alexnodeland/lynx/web/README.md

# lynx site






The landing page at https://alexnodeland.github.io/lynx/: a scroll-driven three.js scene (GSAP for the scroll timeline, n8ao for ambient occlusion) built with Vite.

Site hero

## Run locally

```sh
npm ci
npm run dev       # dev server
npm run build     # production build into dist/
npm run preview   # serve dist/
```

## Layout

| Path | Contents |
|---|---|
| `index.html` | the landing page |
| `build.html` | the 3D build guide |
| `flash.html` | the web flasher (ESP Web Tools; CI builds `public/flash/lynx.bin` in) |
| `src/stage.js` | the shared scene: renderer, light, set, product rig, cables, post-processing |
| `src/guide.js` | the build guide's steps (what arrives, from where, what you need) |
| `src/build.js` | the build guide: ghosts, fly-ins, framing, orbit, step rail, `#step` links |
| `src/main.js` | the landing page: scroll timeline, shots, chrome |
| `src/materials.js` | materials |
| `src/style.css` | styles |
| `public/assets/` | `lynx.glb` (the model), `set.glb` (the desk set), `rig.json`, `studio_1k.hdr` |
| `public/draco/` | Draco decoder for the compressed glTF |

## Deploy

[`.github/workflows/pages.yml`](../.github/workflows/pages.yml) runs `npm ci && npm run build` and publishes `dist/` to GitHub Pages on every push to `main` that touches `web/`.

## Screens

| | |
|---|---|
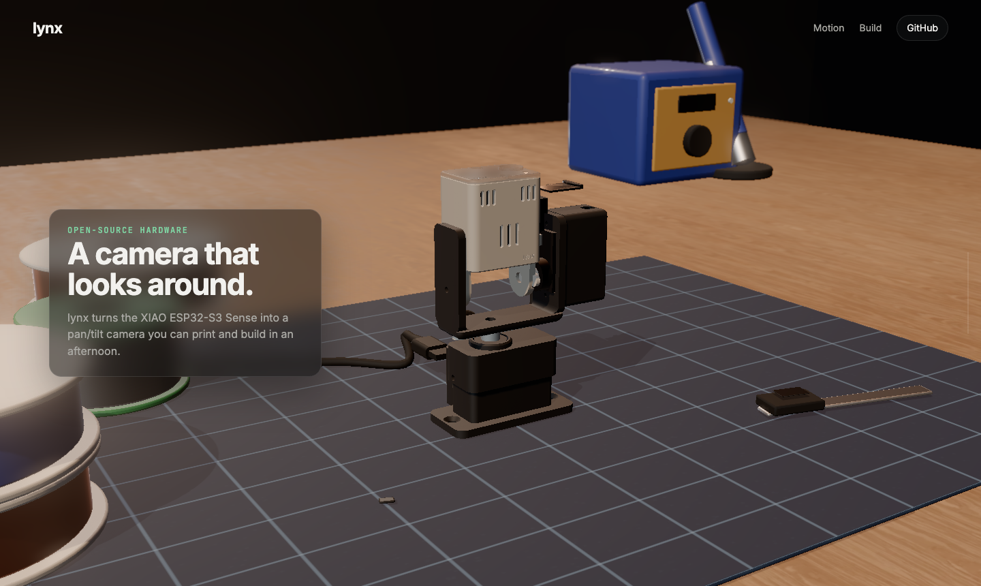
[picture p8: media/web/01-hero.png]
Hero
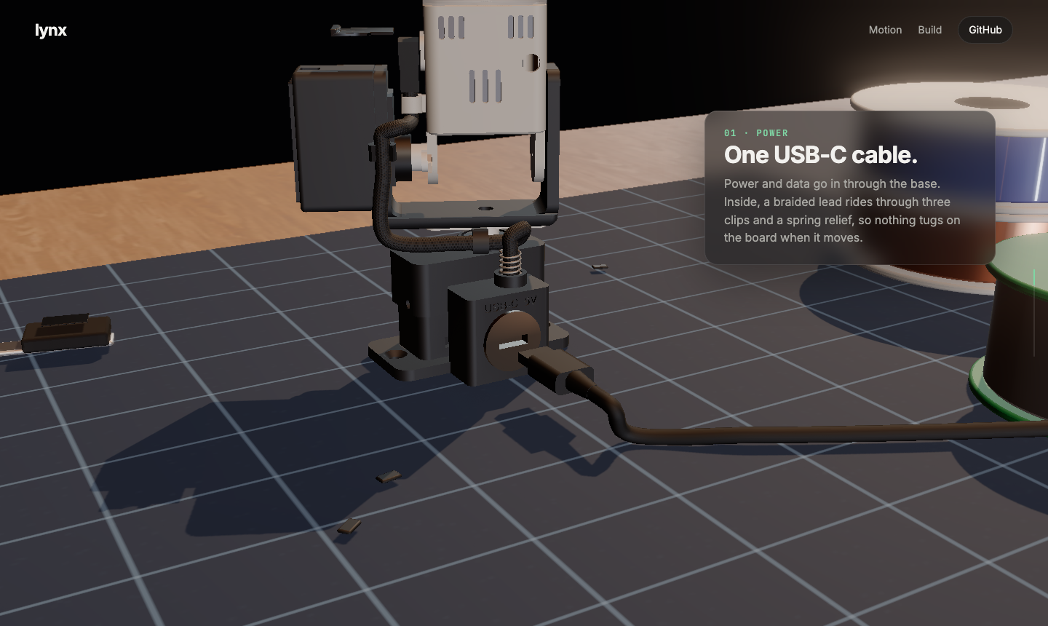
[picture p9: media/web/02-usb.png]
USB-C
|  |  |
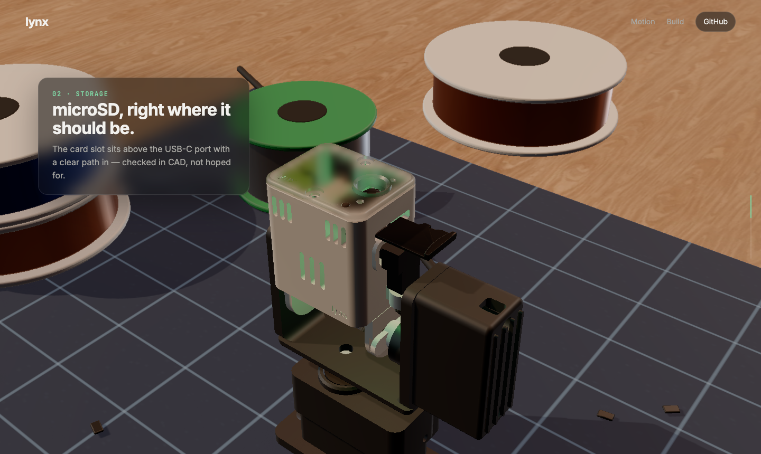
[picture p10: media/web/03-sd.png]
microSD
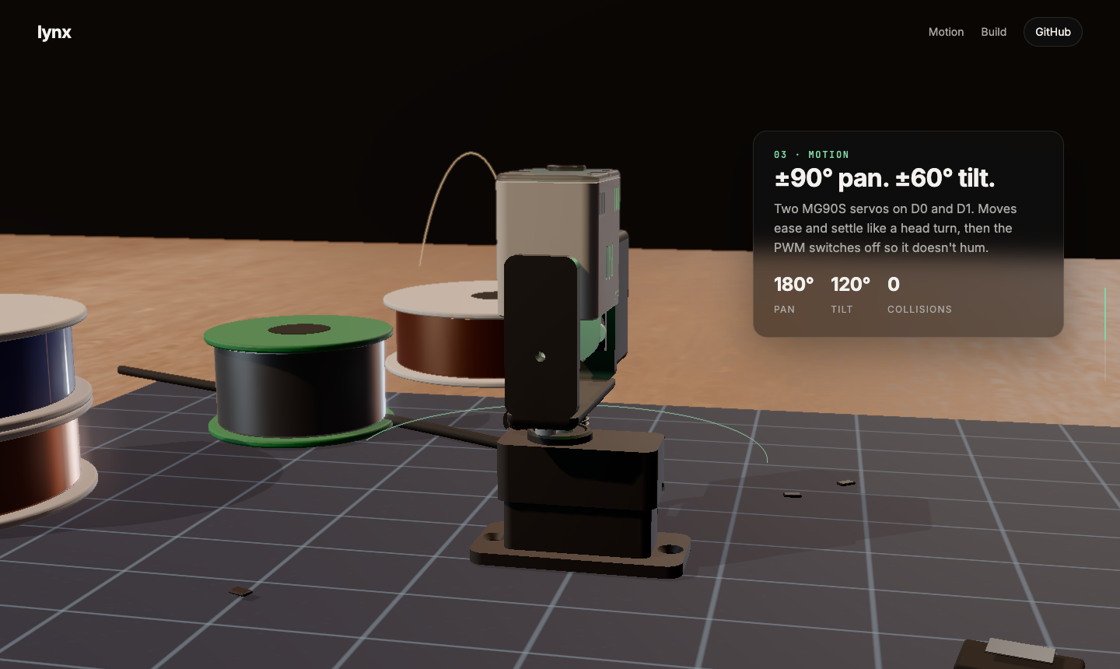
[picture p11: media/web/04-motion.png]
Motion
|  |  |
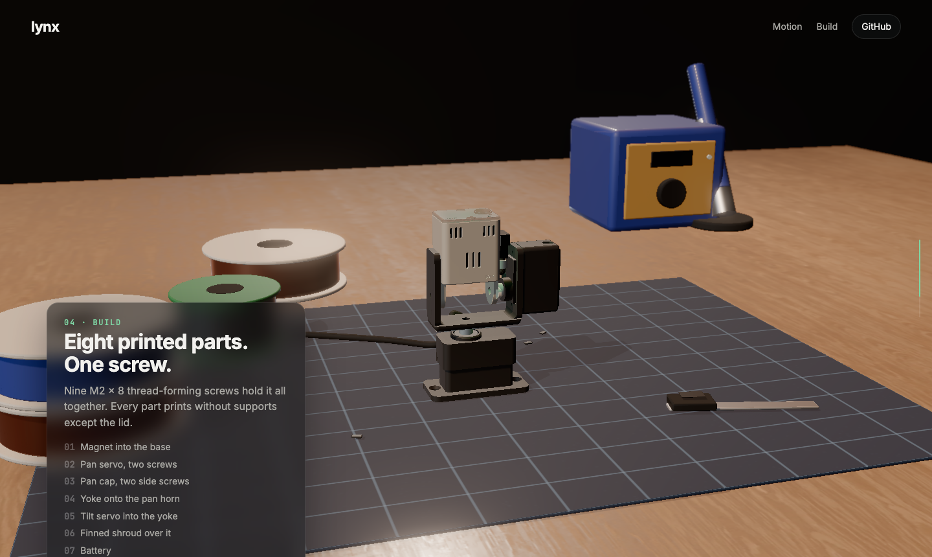
[picture p12: media/web/05-build.png]
Build
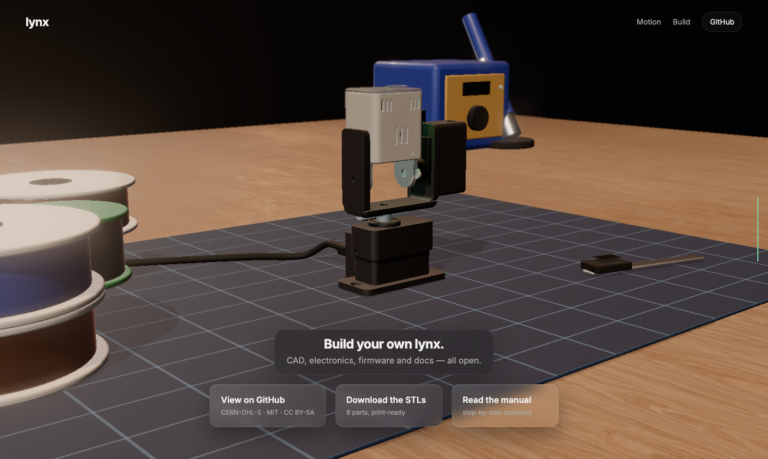
[picture p13: media/web/06-cta.png]
Call to action
|  |  |
