alexnodeland/lynx/firmware/lynx/README.md

# lynx firmware







Firmware for **lynx**, the open-source pan/tilt camera on a Seeed Studio XIAO
ESP32-S3 Sense. One image runs the whole product:

- **Servos:** eased pan/tilt motion with soft limits, resting at tilt 45° (lens leaning toward the front).
- **Camera:** JPEG snapshots and an MJPEG live stream.
- **On-device detection:** faces or cat faces, with boxes. **Follow mode** turns the head to keep the nearest face in frame.
- **Control layer on your network:** a REST API, an **MCP server** for AI agents, and a small dashboard.
- **Setup:** a first-boot Wi-Fi hotspot with a captive setup page.

Every API call needs a per-device token.

**Install from a browser:** [alexnodeland.github.io/lynx/flash.html](https://alexnodeland.github.io/lynx/flash.html)
(Chrome or Edge, USB-C). Or build it yourself, below.

> **Status:** first bring-up on a XIAO ESP32-S3 Sense done on 2026-10-20 (no servos attached).
> These are verified: boot, camera and PSRAM, the captive setup page popping up on a phone, the join,
> mDNS from macOS, the hotspot closing, REST, MCP (both protocol generations, the Origin guard,
> token checks, snapshot images) and the MJPEG stream. Still open: servos under load, brownout,
> `claude mcp add` end to end, and the web flasher. 71 native tests (motion, MCP, auth and throttle, network plan, follow, presets, recorder) run in CI.

## How it fits together

```mermaid
flowchart LR
  subgraph lynx["lynx (XIAO ESP32-S3 Sense)"]
    API["port 80<br/>pages · REST · /mcp · /snapshot.jpg"]
    STREAM["port 81<br/>/stream (MJPEG)"]
    CORE["motion core<br/>(lib/motion)"]
    CAM["camera<br/>(esp32-camera)"]
    API --> CORE
    API --> CAM
    STREAM --> CAM
    CORE --> SERVOS["pan + tilt servos"]
  end
  AGENT["AI agent<br/>(MCP client)"] -- "POST /mcp + token" --> API
  APP["scripts, apps"] -- "REST + token" --> API
  VIEW["browser · VLC · Home Assistant"] -- "MJPEG + token" --> STREAM
```

## Setup (first boot)

```mermaid
sequenceDiagram
  participant P as Phone
  participant L as lynx
  participant W as Home Wi-Fi
  L->>L: first boot: no network saved
  L-->>P: opens hotspot "lynx-xxxx"
  P->>L: joins it; captive page opens
  P->>L: picks network + password
  L->>W: joins
  L-->>P: "online at lynx-xxxx.local" + device token
  Note over L: hotspot closes 3 min later
```

1. Power lynx on. With no saved network it opens an open Wi-Fi hotspot named
   **`lynx-xxxx`** (the last four hex digits of its MAC address, so two units don't collide).
2. Join it from a phone. The setup page opens by itself; if it doesn't, browse to `http://192.168.4.1/`.
3. Pick your network (2.4 GHz) and type its password. The page then shows the
   device's address (`http://lynx-xxxx.local/`) and its **token**. Save the token.
4. Reconnect the phone to your own Wi-Fi and open the address. The dashboard asks for
   the token once, then shows the live view, controls, and copy-paste snippets for MCP and curl.

To get back into setup (new network, lost token), **hold the BOOT button for 3 s**.
The hotspot reopens for 10 minutes. If lynx can't reach its saved network for 20 s,
it reopens the hotspot by itself and keeps retrying the network.

## Wiring

```mermaid
flowchart LR
  XIAO["XIAO ESP32-S3 Sense"] -- "D0 / GPIO1" --> PAN["Pan servo"]
  XIAO -- "D1 / GPIO2" --> TILT["Tilt servo"]
  XIAO -- "5V (USB VBUS)" --> RAIL["5V rail + 470 µF"]
  RAIL --> PAN
  RAIL --> TILT
```

| From | To |
|---|----|
| Pan servo signal (orange/yellow) | XIAO **D0** (GPIO1) |
| Tilt servo signal | XIAO **D1** (GPIO2) |
| Both servo V+ (red) | XIAO **5V** pin (USB VBUS) |
| Both servo GND (brown) | XIAO **GND** |
| 470 µF electrolytic | across 5V–GND, close to the servo connectors, **− to GND** |

Servos run from USB VBUS only; on battery they are unpowered (the 5V pin is
not boosted), so the head will not move on battery.

> **Safety / current:** an MG90S/SG90 draws ~0.7–1 A at stall *each*, and both
> can stall together at a hard stop or under load. Use a USB supply rated
> **≥ 1 A** (2 A is comfortable). A weak port or long thin cable will brown out
> the ESP32 (resets, Wi-Fi drops). Don't let a servo push against a mechanical
> stop — that is why the soft limits sit 2° inside the CAD limits and why PWM
> detaches when idle.

## Build and flash

PlatformIO, Arduino framework, board id `seeed_xiao_esp32s3` (present in the
pinned `espressif32@6.9.0` platform).

```sh
pio run -e xiao                 # build
pio run -e xiao -t upload       # flash over USB-C
pio device monitor -b 115200    # serial console
pio test -e native              # motion, MCP and auth unit tests on the host
```

If upload doesn't find the board, hold **BOOT**, tap **RESET**, release BOOT,
and upload again.

## Layout

Pure logic lives in `lib/`. It has no Arduino includes, builds for the board and for
`env:native`, and is unit-tested there. Hardware glue lives in `src/`.

| Path | What |
|---|---|
| `lib/motion/` | motion core: targets, glance easing, speed limit, soft limits, idle detach, sweep |
| `lib/mcp/` | stateless MCP server (tools only) over a `Device` interface |
| `lib/auth/` | token generation and constant-time check, Bearer / `?token=` parsing, Origin guard |
| `src/main.cpp` | servo PWM, serial console, status JSON, the motion lock |
| `lib/follow/` | follow mode: detection → pan/tilt corrections (deadband, step cap, signs, hold then return to rest) |
| `lib/presets/` | named positions, the patrol that tours them, and the arbiter: manual > follow (with a target) > patrol |
| `lib/netplan/` | when the setup hotspot opens and closes, and the join state: pure rules, unit-tested |
| `src/net.*` | carries out the netplan: hotspot + captive DNS, station mode, mDNS (with IPv6), BOOT button |
| `src/web.*` | `esp_http_server` on port 80: pages, REST, MCP, snapshot |
| `lib/recorder/` | what to record (a burst when something appears, then one per 30 s; timelapse) and what to delete (oldest first, past 90 % full) |
| `src/sdcard.*` | microSD (SPI, CS 21): the recorder task, file listing / download / delete, NTP-dated names |
| `src/ota.*` | over-the-air updates: image checks, SHA-256, the spare slot, self-confirmation for rollback |
| `src/stream.*` | port 81: one frame producer shared by up to 4 clients (MJPEG viewers, `/events` subscribers), a task each |
| `src/camera.*` | esp32-camera on the XIAO Sense pins |
| `src/detect.*` | ESP-DL face / cat-face detection in its own task, on a scaled copy of each JPEG |
| `src/detect_ei.*` | an optional Edge Impulse model (`lib/lynx_model`, from `just model-add`) as the `custom` detector |
| `src/pages.h` | setup page, dashboard, shared CSS (no external assets) |
| `src/settings.*` | NVS (Preferences, namespace `lynx`): calibration, Wi-Fi, token, camera |
| `tools/merge_bin.py` | post-build: `lynx.bin`, one image to flash at 0x0 (used by the web flasher) |
| `test/` | Unity tests: `test_motion`, `test_mcp`, `test_auth`, `test_netplan`, `test_follow`, `test_presets` |

The HTTP servers run in their own FreeRTOS tasks, so every touch of the motion
core goes through a recursive mutex (`MotionLock`). Port 81 is a small server of its own: one task
takes each camera frame once and shares it, and every viewer or event subscriber gets its own task with a
send timeout, so a slow client only slows itself and can never block a control request. The servos own LEDC
timers 0 and 1 (ESP32Servo explicit allocation), and the camera clock uses timer 3,
channel 7, so they never collide.

**Why ESP32Servo rather than raw LEDC:** the LEDC API changed between
arduino-esp32 2.x (`ledcSetup`/`ledcAttachPin`) and 3.x (`ledcAttach`);
ESP32Servo (pinned 3.0.6) hides that, handles timer/channel allocation and
microsecond writes, and has `detach()` to stop the pulse train. The motion core
only produces a pulse width, so swapping to raw LEDC later touches only
`driveServos()`.

## Motion

```mermaid
stateDiagram-v2
  [*] --> Detached
  Detached --> Moving: command (pan / tilt / look / center / sweep)
  Moving: Moving — eased toward overshoot (75 % of duration)
  Moving --> Settling
  Settling: Settling — eased back onto target
  Settling --> AtRest
  AtRest --> Moving: new command
  AtRest --> Detached: idle ms elapsed (default 1500)
```

Every move uses a "glance" profile: ease-in-out up to a small overshoot
(6 % of the distance, capped at 4°) at 75 % of the duration, then an eased
settle back onto the target — no wind-up at the start, like a head turn.
Duration is `180 ms + 4 ms/°` unless given; either way it is stretched so the
peak speed never exceeds `speed` (default 300 °/s). Targets and the overshoot
itself are clamped to the soft limits. Both axes of a `look` share one
duration so they arrive together. After `idle` ms at rest (default 1500) the
PWM is detached so the servos stop humming/jittering; the next move reattaches.
Everything runs from `loop()` on `millis()` (wrap-safe) — no blocking delays.

## Calibration

Defaults: 500–2500 µs at 50 Hz, centre 1500 µs, 11.11 µs/°, soft limits
pan ±88°, tilt ±58°. All of it is per axis and persisted by `save`.

1. Remove the horn or keep the head clear, power over USB, open the monitor.
2. `look 0 0` (pan centred, **lens pointing straight up**). Fit the horns so the head
   faces straight ahead and the lens points at the ceiling. (`center` then rests it at tilt 45°.)
3. Fine-tune with `trim pan 1520`, `trim tilt 1480` … until it is exactly centred.
4. `pan 45` should turn the head to its left. `tilt 45` must lean the lens toward the
   **front**. If either goes the wrong way, run `invert pan` / `invert tilt`.
5. Check scale: `pan 88` and `pan -88` should land just short of the stops
   symmetric about centre. If the swing is short/long, adjust
   `usperdeg pan <µs>` (servos vary 9.5–11.5).
6. If needed, narrow travel: `limits tilt -45 50`.
7. `save`. Check with `status`.

Settings changes take effect at once but are lost on reset until `save`.

## Serial commands (115200 baud, newline-terminated)

| Command | Effect |
|---|---|
| `pan <deg>` / `tilt <deg>` | move one axis |
| `look <pan> <tilt> [ms]` | move both, optional duration |
| `center` | rest pose: pan 0, tilt 45 |
| `sweep` | demo: pan ends, tilt ends, four corners, home |
| `limits` | print soft limits |
| `limits <axis> <min> <max>` | set soft limits (bounded by mechanical ±90 / ±60) |
| `trim <axis> <us>` | centre pulse width |
| `usperdeg <axis> <us>` | pulse per degree |
| `invert <axis>` | toggle direction |
| `speed <deg/s>` | max speed (10–600) |
| `idle <ms>` | idle-detach time, `0` = never detach |
| `wifi <ssid> <pass>` | save Wi-Fi credentials to NVS and connect |
| `setup` | reopen the setup hotspot for 10 minutes |
| `token` | print the API token |
| `token new` | mint a new token (the old one stops working at once) |
| `info` | name, address, version, camera state |
| `detect [off\|face\|cat]` | detection on with that model, or off; no argument prints what it sees |
| `follow [on\|off]` | follow mode |
| `preset [save\|go\|del] <name>` | named positions; no arguments lists them |
| `patrol on [a,b,c] [dwell] \| off` | tour presets |
| `follow signs <pan> <tilt>` | ±1 each: flip if follow turns the wrong way for how the board sits |
| `save` | persist calibration/limits/speed/idle |
| `status` | JSON status |
| `help` | list commands |

`<axis>` is `pan`/`p` or `tilt`/`t`.

## HTTP API

Base URL `http://lynx-xxxx.local/` (or its IP). Every call needs the token:
`Authorization: Bearer <token>`. `?token=<token>` also works, which is what lets
image and stream URLs go straight into an `<img>`, VLC or Home Assistant.

| Request | Body | Effect |
|---|---|---|
| `GET /api/info` | | name, version, endpoint list. **No token needed**, no secrets |
| `GET /api/status` | | angles, targets, pulse, limits, camera, network, heap |
| `POST /api/position` | `{"pan":30,"tilt":45,"ms":600}` (all optional) | move; answers with status |
| `POST /api/center` | | rest pose (pan 0, tilt 45) |
| `POST /api/sweep` | | demo sweep |
| `POST /api/token/rotate` | | mint a new token and return it; the old one stops working at once |
| `GET /api/camera` | | camera settings |
| `POST /api/camera` | `{"framesize":"SVGA","quality":10,"vflip":false,"hmirror":false,"brightness":0}` | change any of them (saved) |
| `GET /snapshot.jpg` | | one JPEG frame |
| `GET /api/presets` | | named positions and the patrol |
| `POST /api/presets` | `{"action":"save","name":"door"}` (save uses the current position unless `pan`/`tilt` given), `go`, `delete` | up to 8 presets (saved) |
| `POST /api/patrol` | `{"enabled":true,"presets":["door","desk"],"dwellS":10}` | tour presets on a loop (saved; resumes after a reboot) |
| `GET /api/detections` | | the latest detections: boxes `[x, y, w, h]` normalised 0..1, scores, fps |
| `POST /api/detect` | `{"enabled":true,"model":"face","range":"far"}` | detection on/off; `face`, `cat` or `custom` (if installed); `near`/`far` (saved) |
| `POST /api/follow` | `{"enabled":true}` (and `panSign`/`tiltSign`) | follow mode (turns detection on if needed) |
| `POST /api/detect/image` | a JPEG (`?debug=1` returns what the model saw) | run detection on your own image: testing and tuning |
| `GET :81/stream` | `?fps=10` optional | MJPEG live video: several viewers at once (up to 4 connections on :81, a fifth gets `503`) |
| `GET :81/events` | | **server-sent events:** the full status, pushed whenever it changes (a move, a detection, a setting), plus a ping every 15 s |
| `GET /api/sd` / `POST /api/sd` | `{"onDetect":true,"timelapseMin":10}` | microSD status (usage, clock, counts) and recording settings (saved; off by default) |
| `GET /api/sd/list?dir=/lynx` | `dir=/lynx/YYYYMMDD` for a day | recording days, or a day's files |
| `GET /api/sd/file?path=…` | | one recording (JPEG) |
| `POST /api/sd/delete` | `{"path":"/lynx/20261021"}` | a recording, or a whole day |
| `GET /api/update` | | firmware version, running slot, whether a new image is still proving itself |
| `POST /api/update` | an app image (`lynx-app-vX.bin` / `firmware.bin`); optional `X-Lynx-SHA256` header | over-the-air update; see below |
| `POST /mcp` | JSON-RPC | MCP, below |

```sh
TOKEN=...   # from the setup page, or the serial `token` command
curl -X POST http://lynx-1a2b.local/api/position -H "Authorization: Bearer $TOKEN" -d '{"pan":40,"tilt":45}'
curl -o lynx.jpg "http://lynx-1a2b.local/snapshot.jpg?token=$TOKEN"
ffplay "http://lynx-1a2b.local:81/stream?token=$TOKEN"
```

Frame sizes: `QVGA` 320×240, `VGA` 640×480 (default), `SVGA` 800×600, `XGA`,
`HD`, `SXGA`, `UXGA` 1600×1200. Larger sizes mean fewer frames per second.

## MCP

lynx is an MCP server at `POST /mcp` (Streamable HTTP, JSON responses, tools only, stateless).
It speaks both protocol generations:

- **2026-07-28:** `server/discover`. Every request carries its version in `params._meta`,
  and the `MCP-Protocol-Version` / `Mcp-Method` / `Mcp-Name` headers are checked against the body.
- **2025-11-25, 2025-06-18, 2025-03-26:** the `initialize` handshake. No session ids are minted.

`GET`/`DELETE /mcp` answer `405`: there is no server-to-client stream. A browser
`Origin` must name the device itself (DNS-rebinding guard).

| Tool | Arguments | Returns |
|---|---|---|
| `guide` | | the manual for agents (the same text as the `lynx://guide` resource) |
| `status` | | the status JSON (also as `structuredContent`) |
| `look` | `pan` −88..88, `tilt` −58..58, `ms` optional | text: where it's moving and how long it takes |
| `center` | | rest pose |
| `sweep` | | demo sweep |
| `snapshot` | `annotate` (optional) | an `image` (base64 JPEG); with `annotate: true`, the current detections drawn on it as green boxes |
| `stream_url` | | the MJPEG and snapshot URLs: video doesn't travel over MCP |
| `set_camera` | `framesize`, `quality`, `vflip`, `hmirror`, `brightness` | confirmation |
| `detect` | `enabled`, `model` (face/cat), `range` (near/far), all optional | what's in view: count, positions, boxes |
| `follow` | `enabled` | follow the nearest face on/off |
| `preset` | `action` (list/go/save/delete), `name`, `pan`/`tilt` | named positions |
| `patrol` | `enabled`, `presets`, `dwell_s` | tour presets on a loop |
| `recordings` | `action` (status/configure/list/get), `path`, `on_detect`, `timelapse_min` | the microSD card; `get` returns a recording as an image |

Every tool has a title, a description for each argument, and the standard hints
(`readOnlyHint`, `idempotentHint`, `destructiveHint`), so clients can ask before a tool that changes something.

**What the agent is told.** An agent learns how to use the camera from three places, so it works whether or not
its client shows resources or prompts:

- **`instructions`** (sent on `initialize` and `server/discover`): the short version. It covers angles and
  which way is positive, waiting for a move before a snapshot, centring a box, who wins control of the head,
  and privacy: detection, not recognition, and asking before anything that keeps running.
- **The `guide` tool and the `lynx://guide` resource** (Markdown): the full manual, with coordinates and field of
  view, detection and centring, presets and patrol, recordings, good practice and recipes.
  `lynx://status` is the live status as a resource.
- **Prompts:** `look_around` (scan the room in four steps and describe it), `find` *thing* (search, centre it
  and take an annotated snapshot), and `check` *place* (go to a preset or spot and report).

```sh
claude mcp add --transport http lynx http://lynx-1a2b.local/mcp --header "Authorization: Bearer $TOKEN"
```

Any other client takes the same URL and header, e.g.
`{"mcpServers":{"lynx":{"type":"http","url":"http://lynx-1a2b.local/mcp","headers":{"Authorization":"Bearer …"}}}}`.
The dashboard prints both with your token filled in.

### Lessons from bring-up

- **ESP-DL found nothing at first.** `jpg2rgb565` writes little-endian pixels, while ESP-DL (like the camera,
  and like `fmt2jpg`) expects the camera's own byte order. Fixed with a byte swap. Even then a
  room-sized face was too small for the stock first-stage scale, so `range: far` gives it a bigger input.
  Both were found with `/api/detect/image?debug=1` and known test images, and that debug path stays in.

- **mDNS stalled for 5 s on macOS/iOS.** They ask for an IPv6 address first, and a v4-only ESP32 never
  answers. The firmware now enables an IPv6 link-local address on the station, and lookups take ~5 ms.
- **The setup hotspot stayed open after joining.** The open/close rules moved into `lib/netplan` with
  explicit timestamps instead of a sentinel, and are now unit-tested over the real sequences:
  fresh setup, a failed first attempt, the router coming back, BOOT re-entry, link drops, millis wrap.
  Hardware confirmed the close.
- A first boot used to log one `NOT_FOUND` line per missing setting. Reads now check the key first.
- Every frame black = a dark room, not a fault: the sensor's auto-exposure is fine once there's light.

## Detection and follow

lynx runs **ESP-DL** on the board itself. That's Espressif's model library, which ships with this toolchain.
It detects **human faces** (two stages, MSR01 then MNP01) or **cat faces** (MN03). It works on a 320×240
copy of each frame, so the stream and snapshots don't slow down: they held 20 fps with detection on at bring-up.
It runs at about 3.6 fps with `range: far` and about 4.1 fps with `near`.

- **Detection, not recognition.** It finds *a* face; it doesn't know whose. Nothing leaves the device
  unless you ask for detections over the API.
- **Range.** `near` finds faces at least ~30 % of the frame wide (arm's length). `far` (the default)
  goes down to ~12 %, across a room, at a slightly lower frame rate.
- **Follow** keeps the biggest (nearest) face centred. It makes small, no-overshoot "track" moves at the
  detector's rate, ignores a face that's already close to centre, holds 6 s where it last saw one, then
  glides back to rest. Any manual move (API, MCP, serial, dashboard) pauses follow for 5 s. If it turns
  the wrong way for how your board sits, `follow signs -1 1` (or `1 -1`) on the serial console.
  Flip and mirror settings are already accounted for.
- **Try it without a face in front of the camera:**
  `curl -X POST -H "Authorization: Bearer $TOKEN" --data-binary @photo.jpg http://lynx-xxxx.local/api/detect/image`.
  Add `?debug=1` to get back the image the model actually saw.

**Custom models.** Anything else (a whole-body person, a package, your dog) comes from an Edge Impulse
export: `just capture`, then label and train, then `just model-add export.zip`, and it becomes `model: custom`.
See [docs/custom-models.md](../../docs/custom-models.md). Proven on the board with a public Edge Impulse
export: +0.72 MB flash, ~1.5 fps for a 96 × 96 classifier.

## Over-the-air updates

Update over Wi-Fi from the dashboard's *Firmware* card, from Home Assistant (an update entity that watches
GitHub releases), or with `just ota`. The upload is checked before anything is flashed. It must be an
ESP32-S3 app image (not the merged `lynx.bin` the web flasher uses), and if you send `X-Lynx-SHA256`,
the hash must match. lynx then writes it to the spare slot and reboots.

**It rolls back by itself.** A new image starts *pending verification* and only confirms itself after
45 s of healthy running. If it crashes, hangs (the watchdog resets it) or reboots before then, the
bootloader goes back to the previous image. That was tested on the board with a build that crashes on purpose
(`-DLYNX_CRASH_TEST`): it went back to the good image with no USB. A USB flash is never needed
again, unless the bootloader itself changes.

Each release carries `lynx-vX.bin` (merged: the web flasher, esptool), `lynx-app-vX.bin` (over the air)
and `lynx-vX.json` (both SHA-256s, which Home Assistant checks before it flashes).

## Recording to microSD

With a card in the XIAO's slot, lynx can save **snapshots when it detects something** (a burst of three
as it appears, then one every 30 s while it stays) and a **timelapse** (one frame every N minutes).
Files go to `/lynx/YYYYMMDD/HHMMSS_kind.jpg`, dated in UTC from NTP. Once the card passes 90 %, the oldest
recordings are deleted until it's back under 80 %. **Recording is off until you turn it on**
(`POST /api/sd`, MCP `recordings`, or Home Assistant).

**Verified on the board (v0.4.1, 16 GB FAT32 card):** the card mounted, and the timelapse saved one frame
at once and then one a minute, dated from NTP. Files were listed and fetched over REST and MCP, and deleted
singly and by day. The path guard refused `/etc/passwd` and `..`. Snapshots on detection are native-tested
but not yet seen on the board, because nobody was in front of it.

**The card is read at boot.** After inserting one, restart lynx (unplug and replug it, or update its firmware).
Format it FAT32 with an MBR partition map. A card over 32 GB comes formatted exFAT and must be reformatted.

## Presets and patrol

Save up to 8 named positions (`door`, `desk`); go to one, or let lynx **patrol** them on a loop with a
dwell at each. Three things can want the head at once, and one rule settles it:
**a person's command** (API, MCP, dashboard, serial) wins for 5 s; then **follow**, while it sees a face;
then **patrol**. So a patrolling lynx stops to follow someone who walks in and resumes its round after
they leave.

## Home Assistant

The integration in [`custom_components/lynx`](../../custom_components/lynx) finds lynx through the
`_lynx._tcp` mDNS record (its TXT `id` is the full MAC address, used as the device's unique id) and talks to the API above.

## Security model

- **Token:** 128 random bits from the hardware RNG, minted on first boot and kept in NVS.
  It's required for every endpoint except `/`, `/lynx.css` and `/api/info`, and compared in
  constant time.
- **Wrong tokens are throttled** per client address, on both ports. After 5 misses an address gets
  `429 Too Many Requests` with `Retry-After` for 1 s, doubling with each further miss up to 5 min.
  A right token clears the count, and a quiet address is forgotten after 10 min. It can't be brute-forced
  anyway (2¹²⁸ tokens); the throttle keeps a misconfigured client or a scanner from filling the log and
  tying up the server.
- **Rotation:** `POST /api/token/rotate`, the Home Assistant *Rotate token* button (which stores the new
  token itself), or `token new` on the serial console. The old token stops working at once.
- **Where the token is shown:** on the setup hotspot page, to someone within radio range during setup,
  and on the USB serial console. The LAN dashboard asks for it, then fills it into its copy-paste snippets
  for you.
- **Setup endpoints** (`/setup/*`) answer only on the hotspot interface. The hotspot is open,
  but it's up only on first boot, after BOOT is held, or while the saved network is unreachable.
- **No TLS:** the token crosses your LAN in the clear, like any LAN camera. Don't expose
  lynx to the internet; reach it over a VPN (e.g. Tailscale) if you need remote access.

## Bring-up checklist

None of these can be checked off the board. ✅ = verified at first bring-up (2026-10-20).

1. ✅ **Boot log:** `pio device monitor` prints `lynx 0.3.0 ready as lynx-xxxx` and no `camera:` error.
   `info` → camera ready. `status` → `freePsram` is several MB (PSRAM is detected).
2. **Servos and camera together:** `sweep` while `/stream` is open. Both keep working, with no
   jitter (LEDC timers don't collide) and no resets.
3. **Brownout:** move hard (`look 88 58`, `look -88 -58`) while streaming at UXGA on your USB
   supply. Watch for `Brownout detector` resets. If any, use a 2 A supply or a shorter cable.
4. ✅ (one phone) **Captive portal:** on iOS and Android, joining `lynx-xxxx` pops the setup page by itself.
5. ✅ (macOS) **mDNS:** `ping lynx-xxxx.local` resolves from macOS, Windows and Linux (Android may need the IP).
6. ✅ **Hotspot closes** about 3 minutes after joining, and reopens with BOOT held for 3 s.
7. **MCP:** `claude mcp add …` as above, then ask the agent to "look left and take a snapshot".
8. ✅ **Stream:** three viewers at once got ~15 fps each; a fifth connection gets `503`; `/events` pushed a move and a setting change.
9. **Orientation:** if the image is upside down, `POST /api/camera {"vflip":true}` (or `hmirror`).
10. **Web flasher:** flash a blank board from `flash.html` and repeat step 1.

## License

MIT — see `LICENSES/MIT.txt` at the repo root. Each source file carries
`SPDX-License-Identifier: MIT`.
