alexnodeland/lynx/docs/architecture.md

# Architecture

[← docs](README.md)

lynx is four things that share one model: the **hardware** (a FreeCAD script that generates every part),
the **firmware** on the XIAO ESP32-S3 Sense, the **Home Assistant integration**, and the **website**
(landing page, 3D build guide, web flasher). This page shows how they connect.

## The system

```mermaid
flowchart LR
  subgraph device["lynx"]
    direction TB
    FW["firmware<br/>(firmware/lynx)"]
    SERVOS["pan + tilt servos<br/>D0 / D1"]
    CAM["OV2640 camera"]
    FW --> SERVOS
    FW --> CAM
  end
  HA["Home Assistant<br/>(custom_components/lynx)"] -- "REST :80 · MJPEG + events :81" --> FW
  AGENT["AI agents<br/>(MCP clients)"] -- "POST /mcp" --> FW
  APPS["scripts, apps, VLC"] -- "REST / MJPEG" --> FW
  PHONE["phone"] -- "setup hotspot<br/>(first boot)" --> FW
  SITE["website<br/>(web/)"] -- "web flasher<br/>(USB)" --> FW
```

Every network call carries the per-device token (`Authorization: Bearer`, or `?token=` on image URLs).
The setup hotspot is the one exception: it's reachable only within radio range, and only while setting up.

## Inside the firmware

```mermaid
flowchart TB
  subgraph loop["main loop (Arduino task)"]
    SERIAL["serial console"] --> MOTION
    NET["net.cpp<br/>carries out lib/netplan"]
    MOTION["lib/motion<br/>eased glances, limits, idle detach"] --> PWM["ESP32Servo<br/>LEDC timers 0-1"]
  end
  subgraph http80["httpd :80 (own task)"]
    PAGES["setup page · dashboard"]
    REST["REST /api/*"]
    MCP["lib/mcp<br/>stateless MCP"]
    AUTH["lib/auth<br/>token · Origin"]
  end
  subgraph det["detector (own task, core 1, low priority)"]
    DETECT["detect.cpp<br/>ESP-DL face / cat face"]
  end
  DETECT -- "boxes" --> FOLLOW["lib/follow<br/>track moves"]
  FOLLOW -- "MotionLock" --> MOTION
  subgraph s81[":81 stream server"]
    PRODUCER["frame producer"] --> STREAM["/stream viewers<br/>+ /events, task each, ≤4"]
  end
  REST -- "MotionLock" --> MOTION
  MCP -- "MotionLock" --> MOTION
  REST --> CAMERA["camera.cpp<br/>LEDC timer 3, PSRAM buffers"]
  MCP --> CAMERA
  PRODUCER --> CAMERA
  DETECT --> CAMERA
```

- **Pure logic lives in `lib/`** (motion, MCP, auth, network plan, follow). It has no Arduino includes and
  runs as native unit tests on every push: 67 of them.
- **The HTTP servers run in their own FreeRTOS tasks**, so they reach the motion core only through a
  recursive mutex. Port 81 is its own small server: one producer copies each frame once for up to 4
  clients (viewers and `/events` subscribers), each in its own task, so a viewer can never block a control request.
- **Requests from the HTTP task that change Wi-Fi** (joining from the setup page) are handed to the
  main loop through atomics, so only one task ever drives the Wi-Fi stack.

## First boot to network

```mermaid
stateDiagram-v2
  [*] --> Hotspot: no saved network
  [*] --> Joining: saved network
  Hotspot --> Joining: network picked on the setup page
  Joining --> Online: connected
  Joining --> Failed: 20 s without a connection
  Failed --> Hotspot: hotspot reopens, join keeps retrying
  Online --> HotspotClosing: 3 min after joining (and no BOOT window)
  Online --> Hotspot: BOOT held 3 s
  HotspotClosing --> Online
```

These rules are `lib/netplan`, tested over real sequences, including the first-attempt failure seen at bring-up.

## The model is the source of truth

```mermaid
flowchart LR
  CAD["hardware/cad/build_revD.py<br/>(FreeCAD, parametric)"] --> CHECK["validation report<br/>collision sweep, access paths"]
  CAD --> PROD["export_production.py<br/>STL + STEP + BOM.md"]
  CAD --> GLB["Blender export<br/>lynx.glb + rig.json"]
  GLB --> LANDING["landing page"]
  GLB --> GUIDE["build guide"]
  GLB --> VIDEO["product video"]
```

The website's model, part offsets, pivots and cable routes (`rig.json`) all come out of the same
CAD build, so a design change reaches the site, the video and the printed parts together.

## The website

`web/src/stage.js` builds the shared scene: renderer, studio light, the bench, the product with its
pan/tilt rig and per-part holders, cables rebuilt from CAD waypoints, and post-processing. Two pages drive it:

- `main.js`: the landing page, scroll-driven. A damped spring follows the scroll position, so
  wheel steps glide and flicks are capped.
- `build.js`: the build guide, step-driven. Earlier parts sit assembled, the current ones fly in,
  later ones are ghosts. You can orbit the model.

`flash.html` is the web flasher (ESP Web Tools). CI builds the firmware into the site, so the image
it flashes is always the one from that commit.

## CI

| Workflow | Runs |
|---|---|
| `firmware.yml` | native tests, XIAO build, and the release image on `v*` tags |
| `hass.yml` | ruff, 20 integration tests on HA 2026.10, hassfest, the HACS validator |
| `pages.yml` | firmware build, then the site with the flasher image, deployed to GitHub Pages |
| `lint.yml` | the pre-commit hooks |
