alexnodeland/lynx/.github/social-preview.png

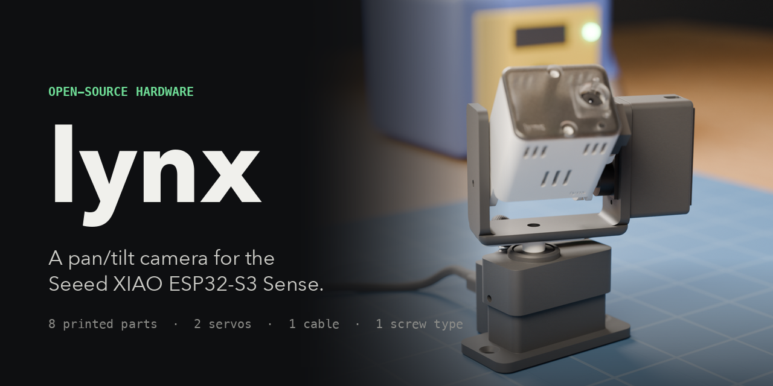
.github/social-preview.png
