alexnodeland/lynx/hardware/production/BOM.md

# lynx — bill of materials

Generated by `export_production.py` from the model; dimensions in mm.

## Printed parts

| File | Size (as printed) | Volume cm³ | Print | Watertight |
|---|---|---|---|---|
| `lynx-base.stl` | 36.0 x 23.9 x 46.3 | 6.18 | Open side down (floor and cheeks up). Supports: off. The floor bridges the cavity. | yes |
| `lynx-lid.stl` | 29.9 x 23.9 x 8.1 | 1.03 | Top face down. Supports: on, touching the build plate only, under the lens-bezel step. | yes |
| `lynx-batterytray.stl` | 26.2 x 20.8 x 12.2 | 0.77 | Plate down, posts up. Supports: off. | yes |
| `lynx-yoke.stl` | 47.9 x 23.0 x 45.2 | 5.25 | Plate down, uprights up. Supports: off. 4 walls / 40 % infill: it carries the camera. | yes |
| `lynx-panbase.stl` | 52.2 x 35.2 x 26.0 | 10.27 | Flange down. Supports: off. | yes |
| `lynx-pancap.stl` | 39.0 x 19.0 x 16.3 | 4.18 | Open side down (collar up). Supports: off. | yes |
| `lynx-servoshroud.stl` | 35.4 x 15.3 x 20.8 | 4.39 | Open end down, fins up. Supports: off. | yes |
| `lynx-lightpipe.stl` | 3.4 x 6.7 x 11.6 | 0.04 | As modelled (arm on the bed, riser up). Clear PETG, 100 % infill, 0.12 mm layers. | yes |

Materials: Base in off-white matte PLA or PETG; Lid in frosted/translucent natural PETG; Yoke, PanBase, PanCap, ServoShroud,
BatteryTray in charcoal PLA/PETG; LightPipe in clear PETG. 0.2 mm layers, 3 walls unless noted.
Print `test-*.stl` first; if fits are off, change `FIT` in build_revD.py and rebuild.

## Electronics

| Qty | Part | Notes |
|---|---|---|
| 1 | Seeed XIAO ESP32-S3 Sense | with its camera, heatsink and FPC antenna |
| 2 | MG90S micro servo — Waveshare 15024 (pishop.us / waveshare.com), or Adafruit SG92R (169) | D0 = pan, D1 = tilt; body 22.8 × 12.2 (stated). Clones vary: check one against the test prints |
| 1 | LiPo 3.7 V 150 mAh — Adafruit 1317 (19.75 × 26.02 × 3.8, JST-PH) | optional backup; cut the JST and solder to the XIAO BAT pads |
| 1 | Panel-mount USB-C extension — Adafruit 6069 (round, 12–18 mm hole, nut) | data pass-through is not stated: confirm before relying on it for flashing |
| 1 | Right-angle USB-C to USB-C, thin, data-capable, 15–20 cm (generic) | needs ~120 mm; plug overmold ≤ 5 mm thick at the board end (Adafruit 6367 fits but is only in stock at 75 mm) |
| 1 | 470 µF 6.3 V electrolytic — Panasonic EEU-FR0J471 (6.3 × 11.2) | across servo 5 V / GND, inside the power pod |
| 1 | microSD card | optional |

## Hardware

| Qty | Part | Where |
|---|---|---|
| 9 | M2 × 8 thread-forming for plastic, pan head — e.g. McMaster 99461A916 | the only screw: lid (2), shroud (2), pan-servo tabs (2), pan cap sides (2), tilt pivot (1) |
| 2 | M3 / #4 countersunk wood screws (optional) | wall-mounting the base; the magnet is the alternative |
| 1 | K&J Magnetics D82, 12.7 × 3.17 mm N42 disc (2.9 kg pull) | pressed into the base underside |
| 1 | compression spring, ~6 mm OD, 10 mm, 0.5 mm wire (McMaster spring finder) | strain relief where the internal cable leaves the pod |
| 1 | 1/4 in PET braided sleeve, ~30 cm — Kable Kontrol FW025 | over the internal USB-C cable |
| 6 | 304 stainless woven mesh ~20 × 20 (McMaster), cut to the `VentMesh` pieces | behind the vent slots (glue) |
| — | thermal pad, 10 × 10 mm | heatsink to board |

## Cost

**About $43 per camera in parts, or about $55 with the battery and a microSD card.** That's what one lynx
uses up. Your first build costs more, because the small parts come in packs. Estimated October 2026 in USD,
single-unit prices, before shipping and tax.

| Part | Each | Per lynx | Source of the price |
|---|---:|---:|---|
| Seeed XIAO ESP32-S3 Sense | $13.99 | $13.99 | Seeed store |
| 2 × micro servo (Adafruit SG92R) | $5.95 | $11.90 | Adafruit 169; MG90S clones are ~$3 |
| Panel-mount USB-C extension (Adafruit 6069) | ~$3.95 | $3.95 | estimate; resellers $2–6 |
| Right-angle USB-C cable, thin, 15–20 cm | ~$7 | $7.00 | estimate, generic |
| 470 µF + 100 nF + 2 × 220 Ω | | $0.75 | distributor single-unit |
| 9 × M2 × 8 thread-forming screws | ~$0.10 | $0.90 | a pack of 100 is ~$10 |
| N42 disc magnet (K&J D82) | $0.99 | $0.99 | K&J Magnetics |
| Spring, braided sleeve, vent mesh, thermal pad | | $2.35 | the share of each pack one build uses |
| Filament, ~40 g PLA/PETG | ~$20/kg | $1.00 | eight parts are 32 cm³ solid |
| **Parts for one lynx** | | **≈ $43** | |
| *Optional:* LiPo 150 mAh (Adafruit 1317) | $5.95 | $5.95 | Adafruit |
| *Optional:* microSD card, 32 GB | ~$6 | $6.00 | estimate |
| **With the options** | | **≈ $55** | |

**First build, out of pocket:** about **$80** before shipping, if you already own a printer and filament. The
difference is minimum packs: screws (~$10/100), springs (~$8 for an assortment), braided sleeve (~$8 a reel),
stainless mesh (~$15 a sheet), thermal pads (~$6), and passives sold in tens. Most of that covers the next
few builds as well.

**The carrier PCB** (option A in [`hardware/electronics`](../electronics)) replaces the hand-wired harness. JLCPCB
makes five bare boards for about $2 plus shipping; having them assembled adds setup and parts fees. The hand-wired
harness costs nothing extra.

Prices move. Adafruit, Seeed and K&J were checked in October 2026; the cable, the panel socket's retail price and
the pack prices are estimates.

## Assembly

1. Press the magnet into the base underside (flush). Screw the panel socket into the pod.
2. Pan servo into the base (two M2 × 8 through its tabs); slide the pan cap over the housing; two M2 × 8 into its sides.
3. Pan horn (centred) into the yoke pocket; press the yoke onto the pan spline; horn screw from above.
4. Tilt servo through the yoke's right upright; slide the shroud over it; two M2 × 8 through the shroud and tabs.
5. Enclosure: battery → tray (clicks in) → board with heatsink (onto the posts) → antenna sticker on the far wall.
6. Light pipe into the lid; lid on; two M2 × 8.
7. Trim the tilt horn to 16 mm; seat it in the drive cheek; set both servos to 90° before fixing the horns.
8. Enclosure between the uprights: horn onto the tilt spline, M2 × 8 pivot through the left upright.
9. Cable: right-angle plug into the board, through the strain clip, upright clip, pan-loop clip, into the pod.
10. Wiring: servo signals to D0/D1, servo 5 V/GND to the XIAO 5V/GND with the capacitor across them.
