alexnodeland/lynx/hardware/production/lynx-assembly.step

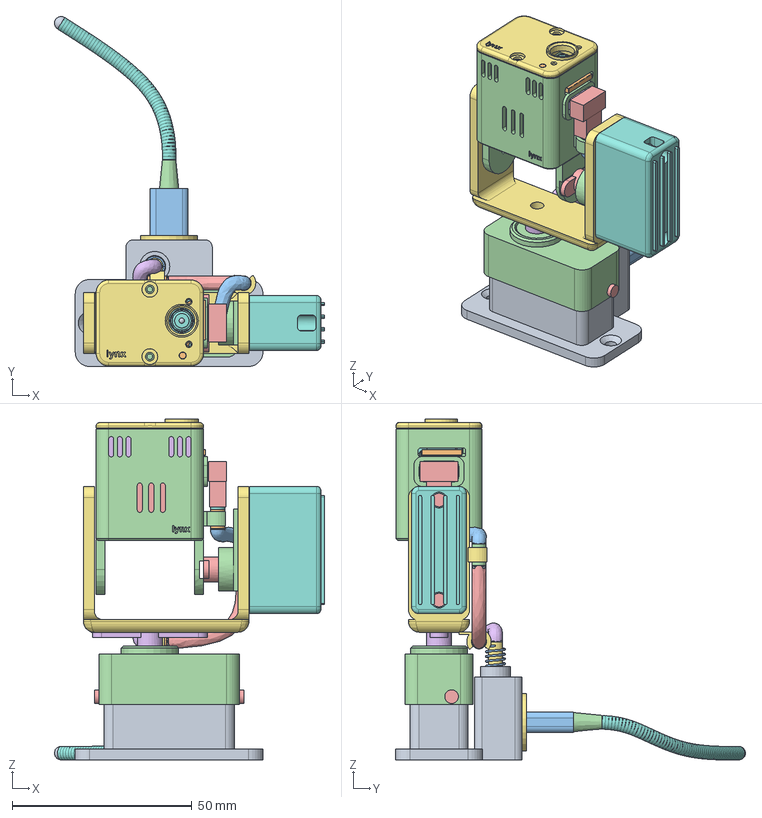
[picture p18: CAD file, 2026-10-20]
hardware/production/lynx-assembly.step
75.1 x 97.3 x 94.8 mm
Jig_XIAO_Sense
Jig_Heatsink
Jig_LiPo_401723
Base
Jig_VentMesh
Lid
Jig_FPC_Antenna
Jig_Antenna_Coax
BatteryTray
Jig_Servo_Tilt
Jig_Horn_Tilt
Jig_Servo_Pan
Jig_Horn_Pan
Yoke
ServoShroud
PanBase
Jig_USBC_PowerPlug
Jig_USB_Plug_RA
Jig_USB_PanelSocket
Jig_USB_Cable_Internal
Jig_USB_Cable_Outside
LightPipePrint
Jig_SpringReliefs
PanCap
Jig_Screws
Jig_Magnet
