alexnodeland/lynx/hardware/electronics/lynx-carrier/fab/lynx-carrier.step

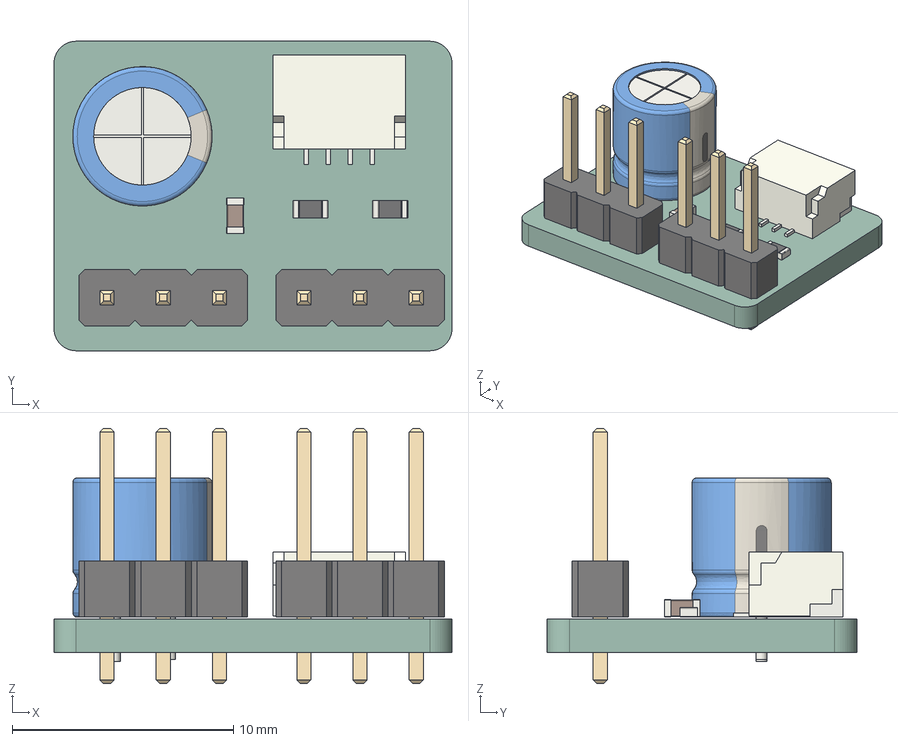
[picture p19: CAD file, 2026-10-21]
hardware/electronics/lynx-carrier/fab/lynx-carrier.step
18.0 x 14.0 x 11.5 mm
JST_SH_SM04B-SRSS-TB_1x04-1MP_P1.00mm_Horizontal
PinHeader_1x03_P254mm_Vertical x 2
C_0603_1608Metric
R_0603_1608Metric x 2
CP_Radial_D63mm_P250mm
lynx-carrier_PCB
