alexnodeland/lynx/hardware/production/lynx-panbase.step

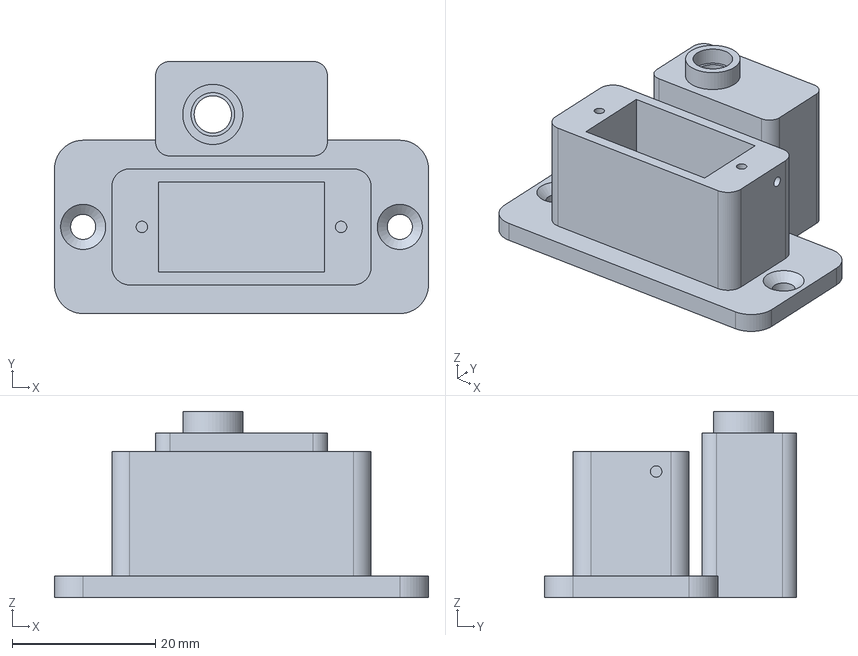
[picture p20: CAD file, 2026-10-20]
hardware/production/lynx-panbase.step
52.2 x 35.2 x 26.0 mm
