alexnodeland/lynx/hardware/production/test-boss.stl

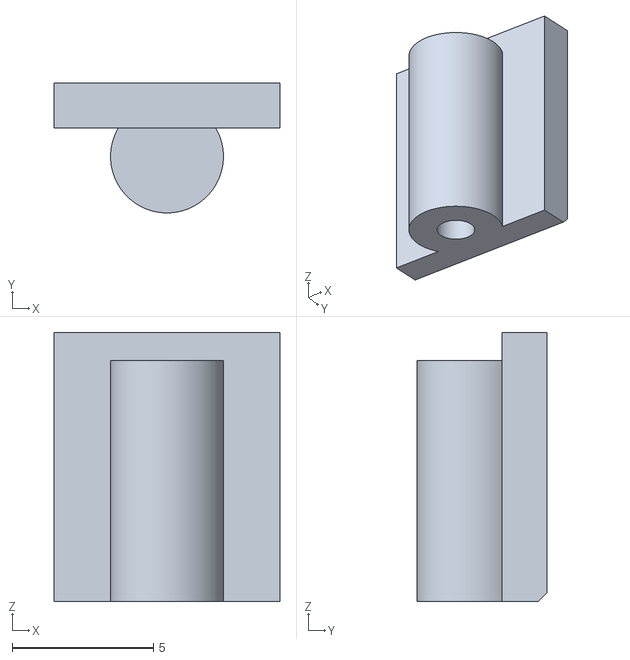
[picture p21: CAD file, 2026-10-20]
hardware/production/test-boss.stl
8.00 x 4.60 x 9.53
