alexnodeland/lynx/hardware/production/lynx-batterytray.step

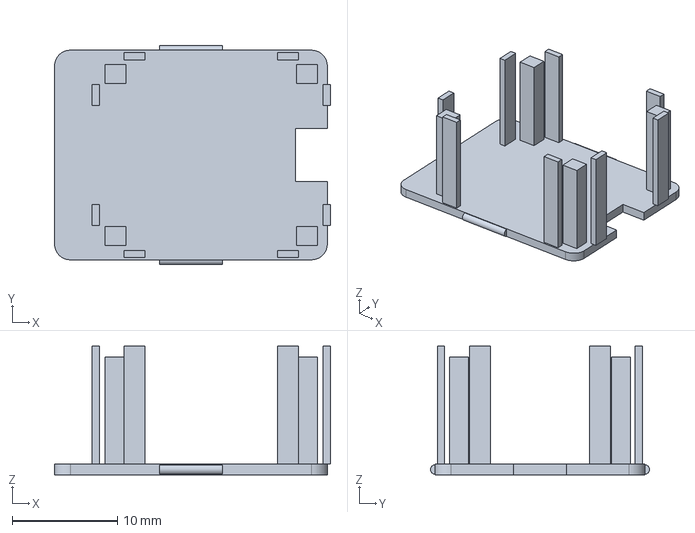
[picture p22: CAD file, 2026-10-20]
hardware/production/lynx-batterytray.step
26.2 x 20.8 x 12.2 mm
