alexnodeland/lynx/hardware/production/test-lidcorner.stl

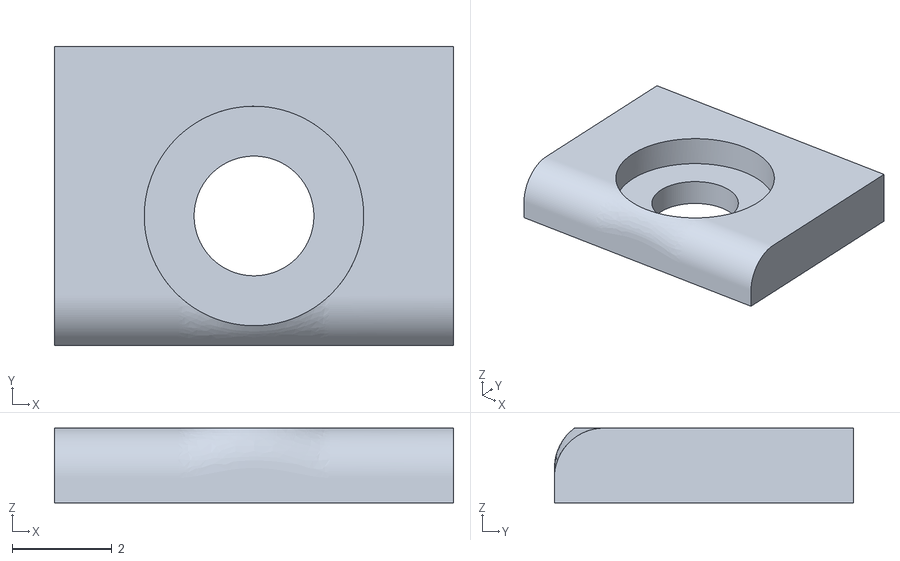
[picture p23: CAD file, 2026-10-20]
hardware/production/test-lidcorner.stl
8.00 x 6.00 x 1.50
