alexnodeland/lynx/hardware/production/lynx-lid.step

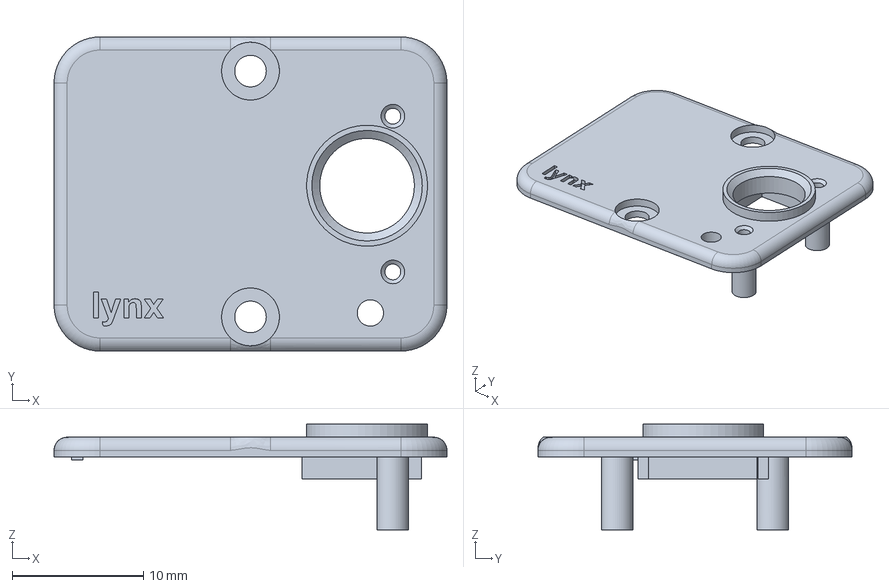
[picture p24: CAD file, 2026-10-20]
hardware/production/lynx-lid.step
29.9 x 23.9 x 8.06 mm
