alexnodeland/lynx/hardware/production/lynx-base.step

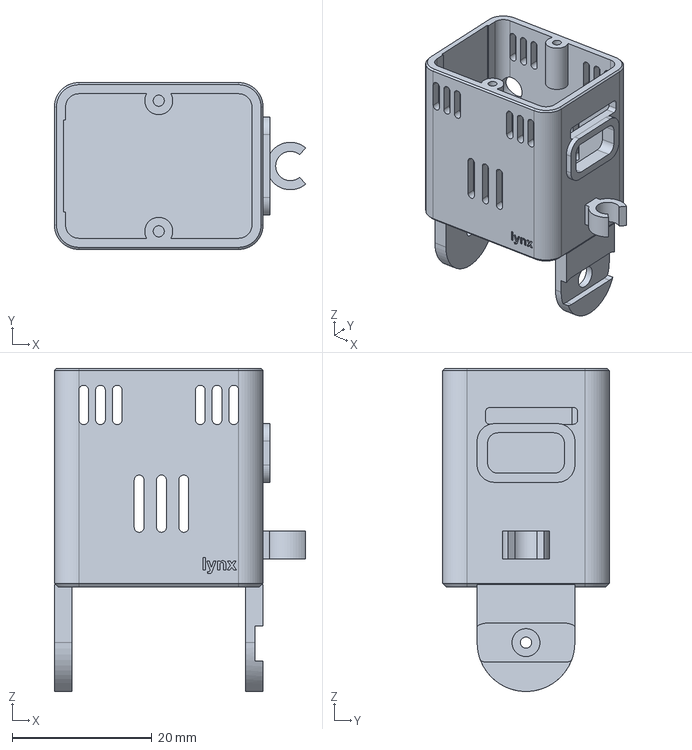
[picture p25: CAD file, 2026-10-20]
hardware/production/lynx-base.step
36.0 x 23.9 x 46.3 mm
