alexnodeland/lynx/hardware/production/test-usbend.stl

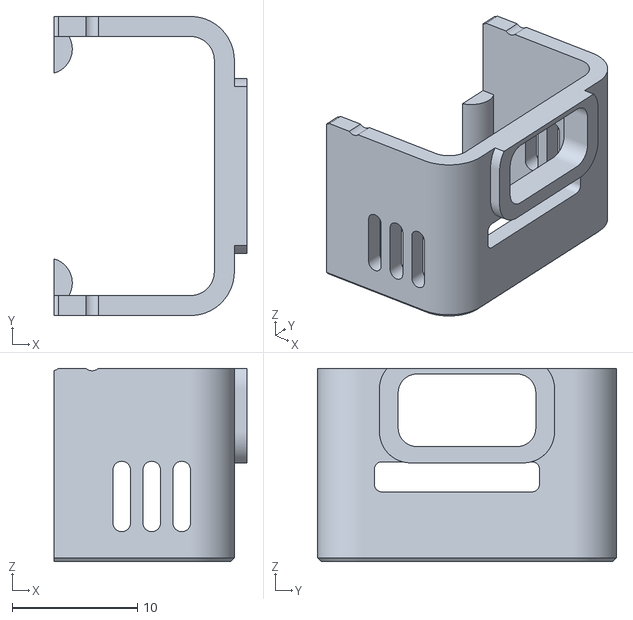
[picture p26: CAD file, 2026-10-20]
hardware/production/test-usbend.stl
15.4 x 23.9 x 15.5
