alexnodeland/lynx/hardware/production/lynx-yoke.step

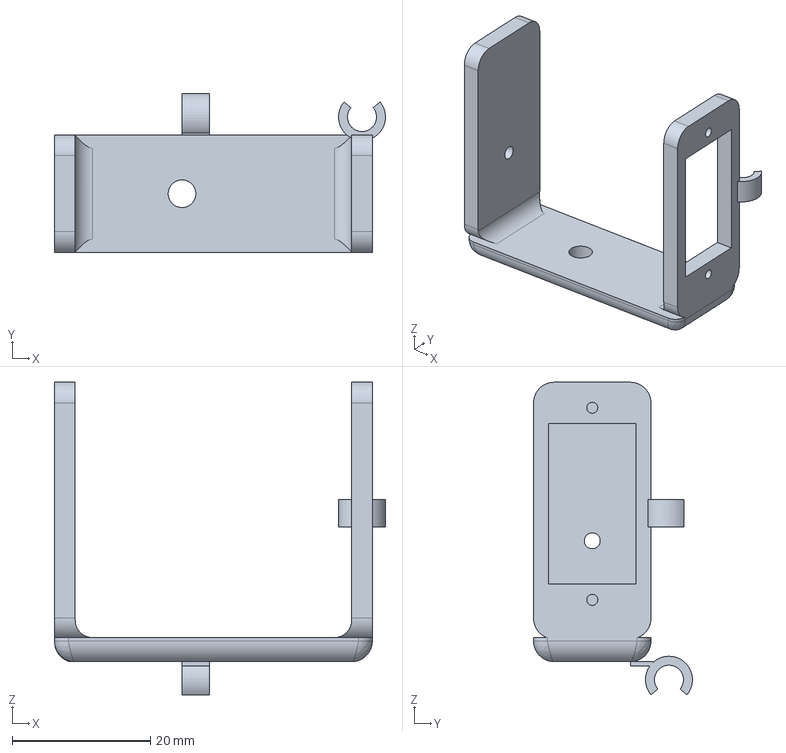
[picture p27: CAD file, 2026-10-20]
hardware/production/lynx-yoke.step
47.9 x 23.0 x 45.2 mm
