alexnodeland/lynx/hardware/production/lynx-servoshroud.step

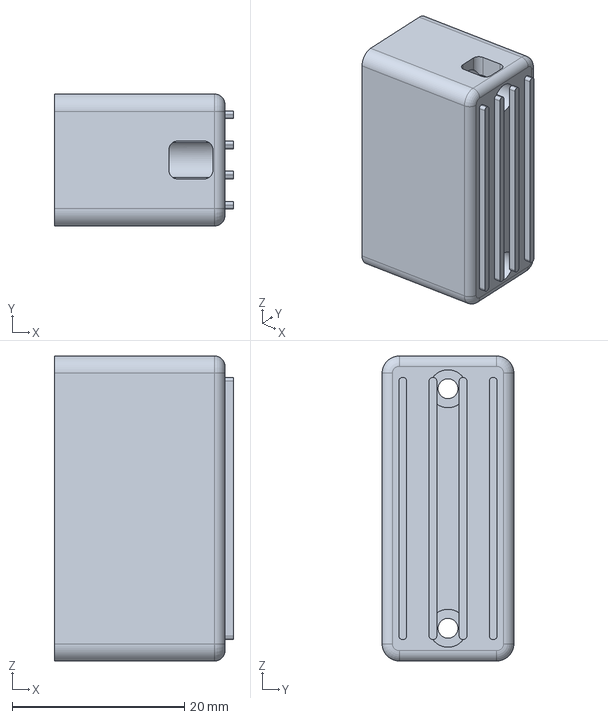
[picture p28: CAD file, 2026-10-20]
hardware/production/lynx-servoshroud.step
20.8 x 15.3 x 35.4 mm
