alexnodeland/lynx/hardware/production/lynx-lightpipe.step

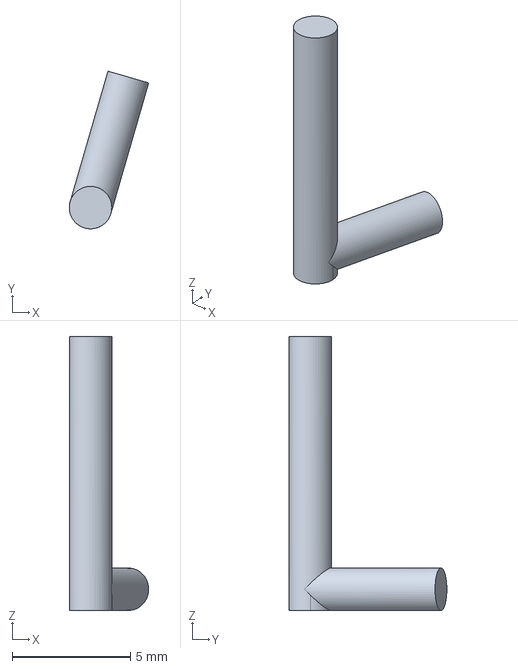
[picture p29: CAD file, 2026-10-20]
hardware/production/lynx-lightpipe.step
3.36 x 6.68 x 11.6 mm
