alexnodeland/lynx/hardware/production/lynx-pancap.step

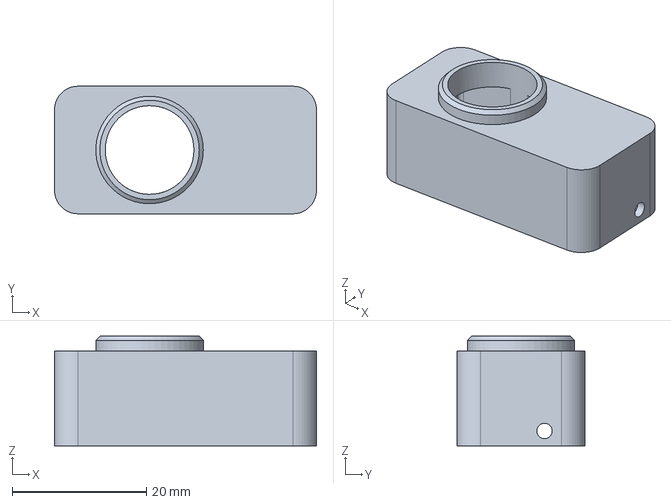
[picture p30: CAD file, 2026-10-20]
hardware/production/lynx-pancap.step
39.0 x 19.0 x 16.3 mm
