alexnodeland/lynx/(list of files, cad)

Other CAD files:
hardware/production/lynx-base.stl
hardware/production/lynx-batterytray.stl
hardware/production/lynx-lid.stl
hardware/production/lynx-lightpipe.stl
hardware/production/lynx-panbase.stl
hardware/production/lynx-pancap.stl
hardware/production/lynx-servoshroud.stl
hardware/production/lynx-yoke.stl
