alexnodeland/lynx/hardware/electronics/lynx-carrier/fab/lynx-carrier-schematic.pdf

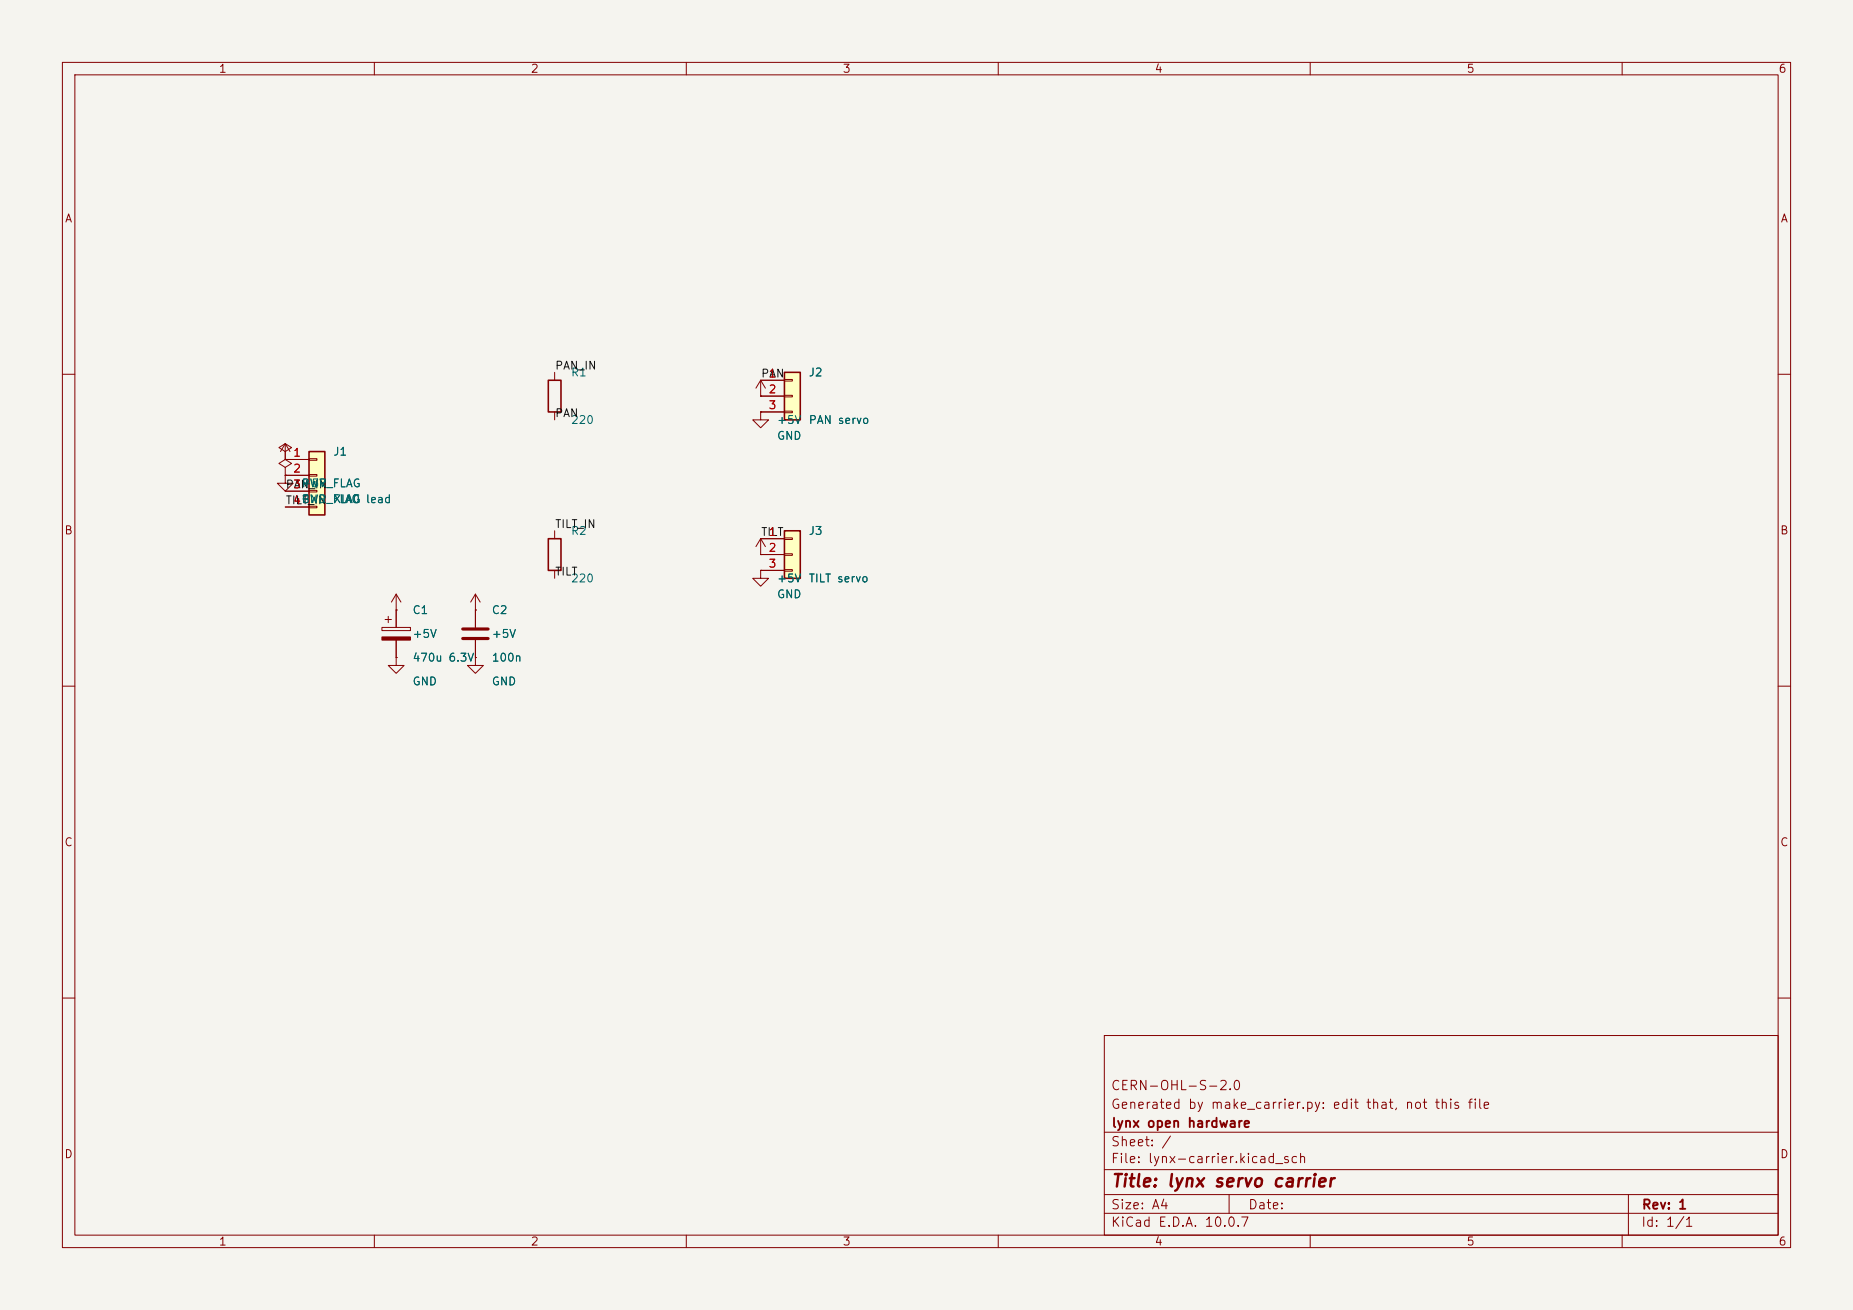
[picture p31: page 1]

CERN-OHL-S-2.0
Generated by make_carrier.py: edit that, not this file
lynx open hardware
Sheet: /
File: lynx-carrier.kicad_sch
Title: lynx servo carrier

Size: A4 | Rev: 1
KiCad E.D.A. 10.0.7 | Id: 1/1
