alexnodeland/lynx/hardware/electronics/lynx-carrier/fab/lynx-carrier-board.pdf/lynx-carrier-B_Cu.pdf

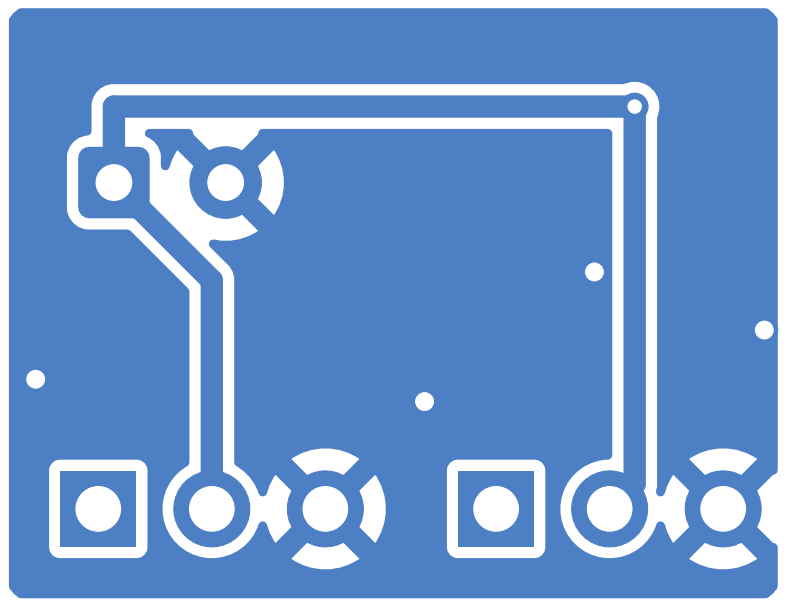
[picture p32: page 1]
