alexnodeland/lynx/hardware/electronics/lynx-carrier/fab/lynx-carrier-board.pdf/lynx-carrier-B_Silkscreen.pdf

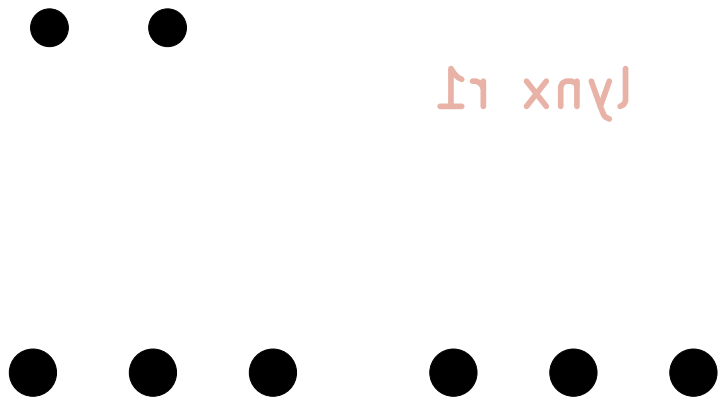
[picture p33: page 1]
