alexnodeland/lynx/hardware/electronics/lynx-carrier/fab/lynx-carrier-board.pdf/lynx-carrier-Edge_Cuts.pdf

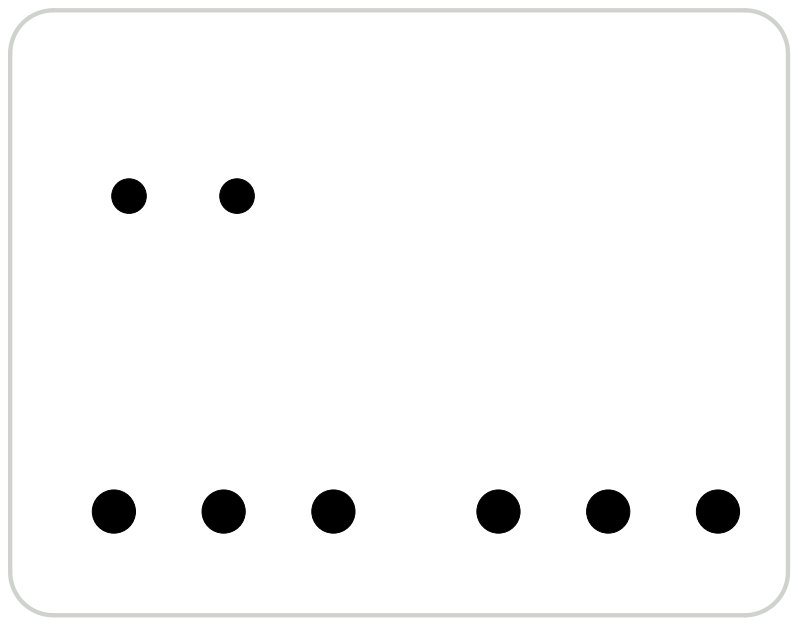
[picture p34: page 1]
