alexnodeland/lynx/hardware/electronics/lynx-carrier/fab/lynx-carrier-board.pdf/lynx-carrier-F_Cu.pdf

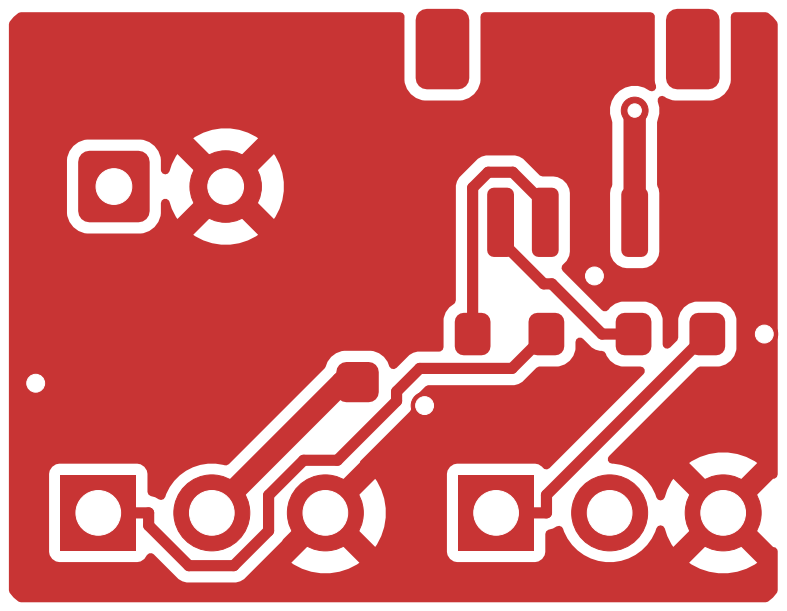
[picture p35: page 1]
