alexnodeland/lynx/hardware/electronics/lynx-carrier/fab/lynx-carrier-board.pdf/lynx-carrier-F_Silkscreen.pdf

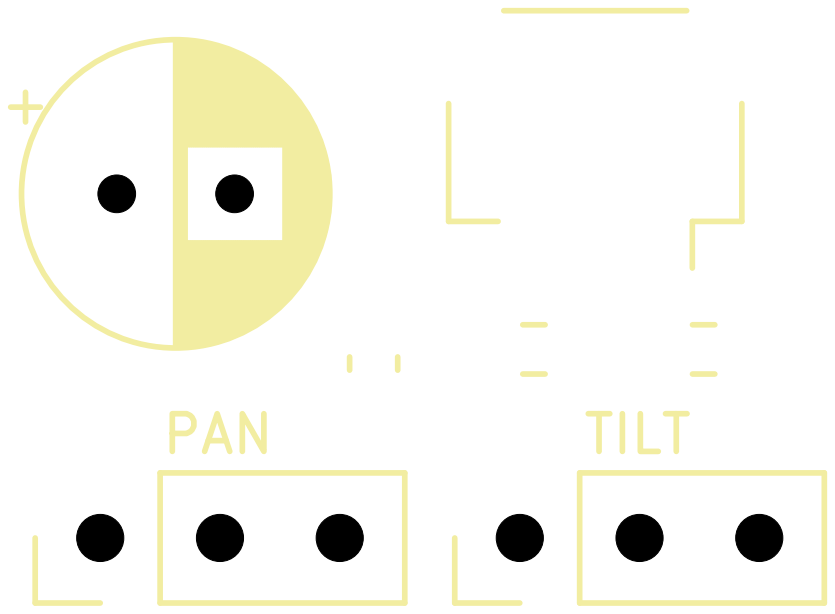
[picture p36: page 1]
