alexnodeland/lynx/hardware/electronics/lynx-carrier/lynx-carrier.kicad_pcb

## KiCad design hardware/electronics/lynx-carrier/lynx-carrier.kicad_pcb (2026-10-21)

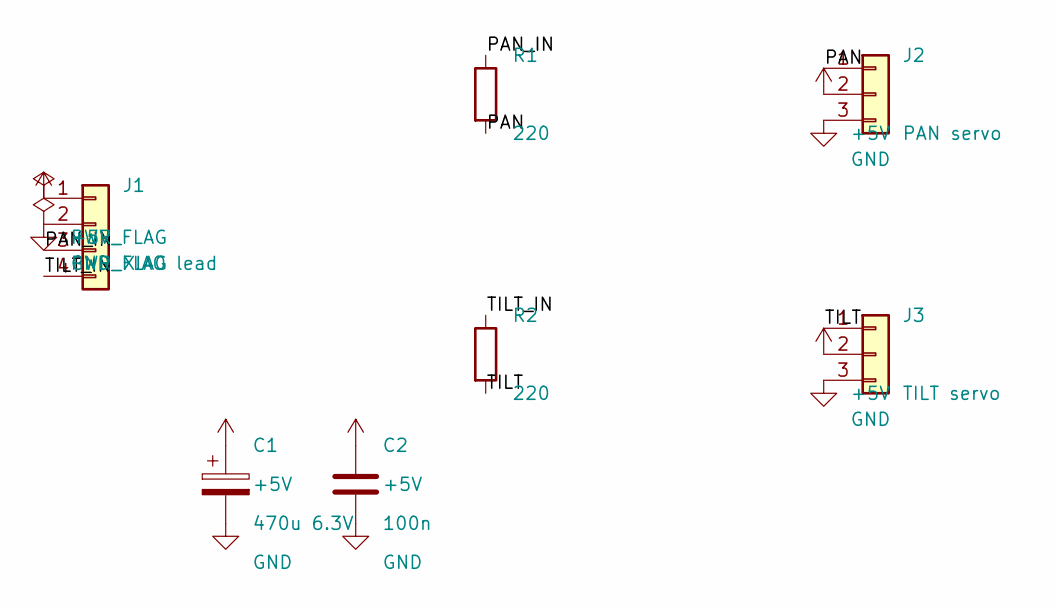
[picture p37: schematic lynx-carrier.kicad_sch, lynx servo carrier]

Parts:
C1: 470u 6.3V; CP_Radial_D6.3mm_P2.50mm; MPN Panasonic EEU-FR0J471
C2: 100n; C_0603_1608Metric; MPN Samsung CL10B104KO8NNNC; LCSC C14663
J1: XIAO lead; JST_SH_SM04B-SRSS-TB_1x04-1MP_P1.00mm_Horizontal; MPN JST SM04B-SRSS-TB; LCSC C160390
J2: PAN servo; PinHeader_1x03_P2.54mm_Vertical; MPN 2.54 mm 1x3 header
J3: TILT servo; PinHeader_1x03_P2.54mm_Vertical; MPN 2.54 mm 1x3 header
R1, R2: 220; R_0603_1608Metric; MPN Yageo RC0603FR-07220RL; LCSC C22962

Connections:
+5V: C1.1, C2.1, J1.1, J2.2, J3.2
/PAN: J2.1, R1.2
/PAN_IN: J1.3, R1.1
/TILT: J3.1, R2.2
/TILT_IN: J1.4, R2.1
GND: C1.2, C2.2, J1.2, J2.3, J3.3

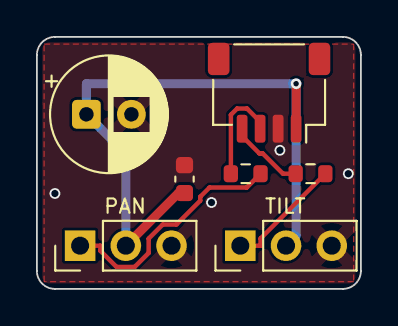
[picture p38: board lynx-carrier.kicad_pcb from above]

Board: 2 copper layers, 18.0 x 14.0 mm, 7 parts (0 on the bottom side), 6 nets.
