alexnodeland/lynx/firmware/lynx/src/main.cpp

// SPDX-License-Identifier: MIT
// lynx firmware: pan/tilt servos, camera, and the LAN control layer (REST, MCP, MJPEG stream)
// for the XIAO ESP32-S3 Sense. Hardware glue only; motion, MCP and auth logic live in lib/
// (unit-tested natively).
#include <Arduino.h>
#include <ArduinoJson.h>
#include <ESP32Servo.h>
#include <WiFi.h>
#include <freertos/semphr.h>

#include <atomic>

#include "app.h"
#include "camera.h"
#include "detect.h"
#include "follow.h"
#include "presets.h"
#include "net.h"
#include "ota.h"
#include "sdcard.h"
#include "stream.h"
#include "web.h"

using namespace lynx;

namespace lynx {
Settings settings;
Motion motion;
static SemaphoreHandle_t motionMutex;
void lockBegin() { motionMutex = xSemaphoreCreateRecursiveMutex(); }
MotionLock::MotionLock() { xSemaphoreTakeRecursive(motionMutex, portMAX_DELAY); }
MotionLock::~MotionLock() { xSemaphoreGiveRecursive(motionMutex); }
}  // namespace lynx

static const int kPin[AXIS_COUNT] = {D0, D1};  // pan, tilt
static const char* kName[AXIS_COUNT] = {"pan", "tilt"};
static const float kMechLimit[AXIS_COUNT] = {90.f, 60.f};  // validated in CAD

static Servo servo[AXIS_COUNT];
static bool servoAttached[AXIS_COUNT] = {false, false};
static int lastUs[AXIS_COUNT] = {-1, -1};
static String line;
static String cameraError;
static Follow follower;
static Arbiter arbiter;  // manual > follow (while it has a target) > patrol
static Presets presets;
static Patrol patrol;
static PatrolSaved patrolSaved;

// ---------- hardware ----------

static void driveServos() {
  for (int i = 0; i < AXIS_COUNT; i++) {
    const AxisMotion& ax = motion.axis((Axis)i);
    if (ax.attached()) {
      if (!servoAttached[i]) {
        servo[i].setPeriodHertz(50);
        servo[i].attach(kPin[i], (int)ax.cal().minUs, (int)ax.cal().maxUs);
        servoAttached[i] = true;
        lastUs[i] = -1;
      }
      int us = (int)lroundf(ax.pulseUs());
      if (us != lastUs[i]) {
        servo[i].writeMicroseconds(us);
        lastUs[i] = us;
      }
    } else if (servoAttached[i]) {
      servo[i].detach();  // stop PWM: no hum, no jitter at rest
      servoAttached[i] = false;
    }
  }
}

static void applyCal() {
  for (int i = 0; i < AXIS_COUNT; i++) motion.axis((Axis)i).setCal(settings.cal[i]);
  motion.config() = settings.motion;
}

// Re-issue the current target so a calibration change is visible immediately.
static void refresh() {
  motion.look(motion.axis(PAN).target(), motion.axis(TILT).target(), 300, millis());
}

// ---------- status ----------

namespace lynx {

void statusJson(JsonObject j) {
  {
    MotionLock l;
    for (int i = 0; i < AXIS_COUNT; i++) {
      const AxisMotion& ax = motion.axis((Axis)i);
      JsonObject o = j[kName[i]].to<JsonObject>();
      o["pos"] = ax.position();
      o["target"] = ax.target();
      o["us"] = (int)lroundf(ax.pulseUs());
      o["moving"] = ax.moving();
      o["attached"] = ax.attached();
      o["min"] = ax.cal().minDeg;
      o["max"] = ax.cal().maxDeg;
      o["trim"] = ax.cal().trimUs;
      o["usPerDeg"] = ax.cal().usPerDeg;
      o["invert"] = ax.cal().invert;
    }
    j["sweeping"] = motion.sweeping();
  }
  j["restTilt"] = Motion::kRestTiltDeg;
  presetsJson(j);
  j["idleMs"] = settings.motion.idleDetachMs;
  j["maxSpeed"] = settings.motion.maxSpeedDegPerS;
  cameraJson(j["camera"].to<JsonObject>());
  {
    JsonObject d = j["detect"].to<JsonObject>();
    Detections det = detectLatest();
    uint32_t seen = detectLastSeenMs();
    d["enabled"] = detectEnabled();
    d["model"] = detectModelName(detectModel());
    d["range"] = detectRangeName(detectRange());
    if (detectCustomAvailable()) d["customModel"] = detectCustomName();
    d["count"] = detectEnabled() && millis() - det.at < 2000 ? det.n : 0;
    d["present"] = seen && millis() - seen < 10000;  // seen in the last 10 s: what Home Assistant polls
    if (seen) d["lastSeenAgoMs"] = millis() - seen;
    d["fps"] = det.fps;
    d["follow"] = settings.follow;
    d["tracking"] = settings.follow && follower.tracking(millis());
  }
  JsonObject n = j["network"].to<JsonObject>();
  n["name"] = hostName();
  n["id"] = deviceId();
  n["mdns"] = mdnsName();
  n["ip"] = staIp();
  n["wifi"] = wifiState();
  n["rssi"] = WiFi.status() == WL_CONNECTED ? WiFi.RSSI() : 0;
  n["setupHotspot"] = setupMode();
  if (setupMode()) n["setupClosesInMs"] = setupClosesInMs();
  j["version"] = kVersion;
  {
    JsonObject fw = j["firmware"].to<JsonObject>();
    otaJson(fw);
  }
  sdJson(j["sd"].to<JsonObject>());
  j["uptimeMs"] = millis();
  j["freeHeap"] = ESP.getFreeHeap();
  j["freePsram"] = ESP.getFreePsram();
}

void cameraJson(JsonObject o) {
  o["ready"] = cameraReady();
  if (!cameraReady()) o["error"] = cameraError;
  o["framesize"] = framesizeName(settings.camera.framesize);
  o["quality"] = settings.camera.quality;
  o["vflip"] = settings.camera.vflip;
  o["hmirror"] = settings.camera.hmirror;
  o["brightness"] = settings.camera.brightness;
}

bool applyCameraJson(JsonObjectConst in, std::string& error) {
  eventsPoke();  // /events subscribers hear about it straight away
  CameraSettings c = settings.camera;
  if (!in["framesize"].isNull()) {
    int fs = framesizeFromName(in["framesize"].as<const char*>());
    if (fs < 0) {
      error = "framesize must be one of QVGA, VGA, SVGA, XGA, HD, SXGA, UXGA";
      return false;
    }
    c.framesize = fs;
  }
  if (!in["quality"].isNull()) {
    int q = in["quality"].as<int>();
    if (q < 4 || q > 63) {
      error = "quality must be 4..63 (lower is better)";
      return false;
    }
    c.quality = q;
  }
  if (!in["brightness"].isNull()) {
    int b = in["brightness"].as<int>();
    if (b < -2 || b > 2) {
      error = "brightness must be -2..2";
      return false;
    }
    c.brightness = b;
  }
  if (!in["vflip"].isNull()) c.vflip = in["vflip"].as<bool>();
  if (!in["hmirror"].isNull()) c.hmirror = in["hmirror"].as<bool>();
  settings.camera = c;
  cameraApply(c);
  saveCamera(c);
  return true;
}

void detectionsJson(JsonObject o) {
  Detections d = detectLatest();
  uint32_t now = millis();
  o["enabled"] = detectEnabled();
  o["model"] = detectModelName(detectModel());
  o["range"] = detectRangeName(detectRange());
  if (detectCustomAvailable()) o["customModel"] = detectCustomName();
  if (d.at) o["ageMs"] = now - d.at;
  else o["ageMs"] = nullptr;
  o["fps"] = d.fps;
  o["frame"]["w"] = d.inW;
  o["frame"]["h"] = d.inH;
  uint32_t seen = detectLastSeenMs();
  o["present"] = seen && now - seen < 10000;
  if (seen) o["lastSeenAgoMs"] = now - seen;
  o["follow"] = settings.follow;
  JsonArray a = o["objects"].to<JsonArray>();
  if (!detectEnabled() || !d.at || now - d.at > 2000) return;  // stale: report nothing rather than old boxes
  for (int i = 0; i < d.n; i++) {
    JsonObject b = a.add<JsonObject>();
    b["label"] = d.label[i] ? d.label[i] : detectModelName(d.model);
    b["score"] = roundf(d.box[i].score * 100) / 100;
    JsonArray box = b["box"].to<JsonArray>();  // x, y, w, h, normalised 0..1, origin top-left
    for (float v : {d.box[i].x, d.box[i].y, d.box[i].w, d.box[i].h}) box.add(roundf(v * 1000) / 1000);
  }
}

bool applyDetectJson(JsonObjectConst in, std::string& error) {
  eventsPoke();  // /events subscribers hear about it straight away
  int m = settings.detectModel;
  if (!in["model"].isNull()) {
    m = detectModelFromName(in["model"].as<const char*>());
    if (m < 0) {
      error = detectCustomAvailable() ? "model must be face, cat or custom"
                                      : "model must be face or cat (no custom model is installed)";
      return false;
    }
  }
  int rg = settings.detectRange;
  if (!in["range"].isNull()) {
    rg = detectRangeFromName(in["range"].as<const char*>());
    if (rg < 0) {
      error = "range must be near or far";
      return false;
    }
  }
  bool on = in["enabled"].isNull() ? settings.detect : in["enabled"].as<bool>();
  settings.detect = on;
  settings.detectModel = m;
  settings.detectRange = rg;
  if (!on) settings.follow = false;  // nothing to follow
  detectSet(on, m, rg);
  saveDetect(settings);
  return true;
}

bool applyFollowJson(JsonObjectConst in, std::string& error) {
  eventsPoke();  // /events subscribers hear about it straight away
  if (!in["panSign"].isNull()) settings.followPanSign = in["panSign"].as<int>() < 0 ? -1 : 1;
  if (!in["tiltSign"].isNull()) settings.followTiltSign = in["tiltSign"].as<int>() < 0 ? -1 : 1;
  if (!in["enabled"].isNull()) {
    bool on = in["enabled"].as<bool>();
    if (on && !settings.detect) {  // following needs detection: turn it on with the current model
      settings.detect = true;
      detectSet(true, settings.detectModel, settings.detectRange);
    }
    settings.follow = on;
    follower.reset();
  }
  follower.config().panSign = settings.followPanSign;
  follower.config().tiltSign = settings.followTiltSign;
  saveDetect(settings);
  return true;
}

void pauseFollow(uint32_t ms) {
  MotionLock l;
  arbiter.manual(millis(), ms);
}

void presetsJson(JsonObject o) {
  MotionLock l;
  JsonArray a = o["presets"].to<JsonArray>();
  for (int i = 0; i < presets.count(); i++) {
    JsonObject p = a.add<JsonObject>();
    p["name"] = presets.at(i).name;
    p["pan"] = presets.at(i).pan;
    p["tilt"] = presets.at(i).tilt;
  }
  JsonObject pt = o["patrol"].to<JsonObject>();
  pt["enabled"] = patrol.on();
  pt["dwellS"] = patrol.dwellMs() / 1000;
  JsonArray order = pt["presets"].to<JsonArray>();
  for (int i = 0; i < patrol.length(); i++) {
    int k = patrol.stopAt(i);
    if (k >= 0 && k < presets.count()) order.add(presets.at(k).name);
  }
  int c = patrol.current();
  if (patrol.on() && c >= 0 && patrol.stopAt(c) < presets.count()) pt["at"] = presets.at(patrol.stopAt(c)).name;
}

static void restartPatrol(uint32_t now) {
  patrol.start(patrolSaved.order, patrolSaved.n, patrolSaved.dwellMs, now);
  if (!patrolSaved.on) patrol.stop();
}

bool presetAction(JsonObjectConst in, std::string& error) {
  eventsPoke();  // /events subscribers hear about it straight away
  const char* action = in["action"] | "";
  const char* name = in["name"] | "";
  uint32_t now = millis();
  MotionLock l;
  if (!strcmp(action, "save")) {
    float pan = in["pan"].isNull() ? motion.axis(PAN).target() : in["pan"].as<float>();
    float tilt = in["tilt"].isNull() ? motion.axis(TILT).target() : in["tilt"].as<float>();
    if (!presets.save(name, pan, tilt)) {
      error = presets.count() >= kMaxPresets && presets.find(name) < 0
                  ? "all 8 preset slots are taken; delete one first"
                  : "a name is 1-15 characters: a-z, 0-9, - and _";
      return false;
    }
    savePresets(presets);
    return true;
  }
  int i = presets.find(name);
  if (i < 0) {
    error = std::string("no preset called '") + name + "'";
    return false;
  }
  if (!strcmp(action, "go")) {
    arbiter.manual(now, 5000);
    motion.look(presets.at(i).pan, presets.at(i).tilt, -1, now);
    return true;
  }
  if (!strcmp(action, "delete")) {
    // keep the patrol pointing at the same names after the indices shift
    PatrolSaved ps = patrolSaved;
    char names[kMaxPresets][kPresetNameLen];
    for (int k = 0; k < ps.n; k++) strcpy(names[k], ps.order[k] < presets.count() ? presets.at(ps.order[k]).name : "");
    presets.remove(name);
    patrolSaved.n = 0;
    for (int k = 0; k < ps.n; k++) {
      int j = presets.find(names[k]);
      if (j >= 0) patrolSaved.order[patrolSaved.n++] = j;
    }
    if (patrolSaved.n == 0) patrolSaved.on = false;
    savePresets(presets);
    savePatrol(patrolSaved);
    restartPatrol(now);
    return true;
  }
  error = "action must be save, go or delete";
  return false;
}

bool applyPatrolJson(JsonObjectConst in, std::string& error) {
  eventsPoke();  // /events subscribers hear about it straight away
  MotionLock l;
  PatrolSaved ps = patrolSaved;
  if (!in["presets"].isNull()) {
    ps.n = 0;
    for (JsonVariantConst v : in["presets"].as<JsonArrayConst>()) {
      int j = presets.find(v.as<const char*>());
      if (j < 0) {
        error = std::string("no preset called '") + (v.as<const char*>() ? v.as<const char*>() : "?") + "'";
        return false;
      }
      if (ps.n < kMaxPresets) ps.order[ps.n++] = j;
    }
  }
  if (!in["dwellS"].isNull()) ps.dwellMs = (uint32_t)constrain(in["dwellS"].as<int>(), 1, 3600) * 1000;
  if (!in["enabled"].isNull()) ps.on = in["enabled"].as<bool>();
  if (ps.on && ps.n == 0) {  // default tour: every preset, in order
    for (int j = 0; j < presets.count(); j++) ps.order[ps.n++] = j;
    if (ps.n == 0) {
      error = "save some presets first";
      return false;
    }
  }
  patrolSaved = ps;
  savePatrol(patrolSaved);
  restartPatrol(millis());
  return true;
}

}  // namespace lynx

// ---------- follow mode ----------

static void pollPatrol(uint32_t now) {
  MotionLock l;
  if (!patrol.on()) return;
  bool tracking = settings.follow && follower.tracking(now);
  bool idle = !motion.axis(PAN).moving() && !motion.axis(TILT).moving() && !motion.sweeping();
  Patrol::Step s = patrol.tick(now, arbiter.patrolMay(now, tracking), idle, presets);
  if (s.move) motion.look(s.pan, s.tilt, -1, now);  // a glance between stops
}

static void pollFollow(uint32_t now) {
  static uint32_t lastSeq = 0;
  if (!settings.follow || !detectEnabled()) return;
  MotionLock l;
  float pan = motion.axis(PAN).target(), tilt = motion.axis(TILT).target();
  FollowMove m;
  Detections d = detectLatest();
  if (d.seq != lastSeq) {
    lastSeq = d.seq;
    Target t[8];
    for (int i = 0; i < d.n; i++) {
      // image coordinates -> camera-relative, undoing the flip/mirror the user set for display
      float cx = (d.box[i].x + d.box[i].w / 2) * 2 - 1, cy = (d.box[i].y + d.box[i].h / 2) * 2 - 1;
      if (settings.camera.hmirror) cx = -cx;
      if (settings.camera.vflip) cy = -cy;
      t[i].cx = cx;
      t[i].cy = cy;
      t[i].size = d.box[i].w * d.box[i].h;
      t[i].score = d.box[i].score;
    }
    m = follower.onFrame(now, t, d.n, pan, tilt);
  } else {
    m = follower.tick(now, pan, tilt);
  }
  if (!m.move || !arbiter.followMay(now) || motion.sweeping()) return;
  if (m.rest) motion.look(m.pan, m.tilt, -1, now);  // a calm glance home
  else motion.track(m.pan, m.tilt, 220, now);
}

// ---------- serial commands ----------

static int parseAxis(const String& s) {
  if (s == "pan" || s == "p") return PAN;
  if (s == "tilt" || s == "t") return TILT;
  return -1;
}

static void printHelp() {
  Serial.println(F(
      "lynx commands:\n"
      "  pan <deg>                 move pan (tilt unchanged)\n"
      "  tilt <deg>                move tilt (pan unchanged)\n"
      "  look <pan> <tilt> [ms]    move both, optional duration\n"
      "  center                    return to rest (pan 0, tilt 45)\n"
      "  sweep                     demo the full soft-limit range\n"
      "  limits                    show soft limits\n"
      "  limits <axis> <min> <max> set soft limits (inside mechanical +/-90 pan, +/-60 tilt)\n"
      "  trim <axis> <us>          centre pulse width (e.g. 1500)\n"
      "  usperdeg <axis> <us>      pulse per degree (default 11.11)\n"
      "  invert <axis>             toggle direction\n"
      "  speed <deg/s>             max angular speed\n"
      "  idle <ms>                 detach PWM after idle (0 = never)\n"
      "  wifi <ssid> <pass>        save Wi-Fi credentials and reconnect\n"
      "  setup [s]                 reopen the setup hotspot (default 10 minutes)\n"
      "  token                     print the API token\n"
      "  token new                 mint a new API token (old one stops working)\n"
      "  info                      name, address, version\n"
      "  detect [off|face|cat]     on-device detection (no arg: print what it sees)\n"
      "  follow [on|off]           turn the head to keep a face in frame\n"
      "  follow signs <pan> <tilt> +1/-1 each, for how the board sits in the pod\n"
      "  preset [save|go|del] <name>  named positions (save uses the current position); no args: list\n"
      "  patrol on [a,b,c] [dwell s] | off  tour presets\n"
      "  save                      persist calibration/limits to NVS\n"
      "  status                    print JSON status\n"
      "  help"));
}

static void handleCommand(String cmd) {
  cmd.trim();
  if (!cmd.length()) return;
  String tok[5];
  int n = 0, from = 0;
  while (n < 5 && from < (int)cmd.length()) {
    int sp = cmd.indexOf(' ', from);
    if (sp < 0) sp = cmd.length();
    if (sp > from) tok[n++] = cmd.substring(from, sp);
    from = sp + 1;
  }
  // wifi keeps the remainder as the password (may contain spaces)
  String c = tok[0];
  c.toLowerCase();
  uint32_t now = millis();
  MotionLock lock;  // the HTTP tasks touch motion too
  if (c == "pan" || c == "tilt" || c == "look" || c == "center" || c == "centre" || c == "sweep") pauseFollow();

  if (c == "help" || c == "?") {
    printHelp();
  } else if (c == "pan" && n >= 2) {
    motion.look(tok[1].toFloat(), motion.axis(TILT).target(), -1, now);
  } else if (c == "tilt" && n >= 2) {
    motion.look(motion.axis(PAN).target(), tok[1].toFloat(), -1, now);
  } else if (c == "look" && n >= 3) {
    uint32_t d = motion.look(tok[1].toFloat(), tok[2].toFloat(), n >= 4 ? tok[3].toInt() : -1, now);
    Serial.printf("ok %u ms\n", (unsigned)d);
  } else if (c == "center" || c == "centre") {
    motion.center(now);
  } else if (c == "sweep") {
    motion.startSweep(now);
  } else if (c == "limits" && n == 1) {
    for (int i = 0; i < AXIS_COUNT; i++)
      Serial.printf("%s: %.1f .. %.1f deg (mechanical +/-%.0f)\n", kName[i], settings.cal[i].minDeg,
                    settings.cal[i].maxDeg, kMechLimit[i]);
  } else if (c == "limits" && n >= 4 && parseAxis(tok[1]) >= 0) {
    int a = parseAxis(tok[1]);
    float lo = constrain(tok[2].toFloat(), -kMechLimit[a], 0.f);
    float hi = constrain(tok[3].toFloat(), 0.f, kMechLimit[a]);
    settings.cal[a].minDeg = lo;
    settings.cal[a].maxDeg = hi;
    applyCal();
    Serial.printf("%s limits %.1f .. %.1f (unsaved)\n", kName[a], lo, hi);
  } else if (c == "trim" && n >= 3 && parseAxis(tok[1]) >= 0) {
    int a = parseAxis(tok[1]);
    settings.cal[a].trimUs = constrain(tok[2].toFloat(), settings.cal[a].minUs, settings.cal[a].maxUs);
    applyCal();
    refresh();
    Serial.printf("%s trim %.0f us (unsaved)\n", kName[a], settings.cal[a].trimUs);
  } else if (c == "usperdeg" && n >= 3 && parseAxis(tok[1]) >= 0) {
    int a = parseAxis(tok[1]);
    settings.cal[a].usPerDeg = constrain(tok[2].toFloat(), 1.f, 30.f);
    applyCal();
    refresh();
    Serial.printf("%s %.2f us/deg (unsaved)\n", kName[a], settings.cal[a].usPerDeg);
  } else if (c == "invert" && n >= 2 && parseAxis(tok[1]) >= 0) {
    int a = parseAxis(tok[1]);
    settings.cal[a].invert = !settings.cal[a].invert;
    applyCal();
    refresh();
    Serial.printf("%s invert %s (unsaved)\n", kName[a], settings.cal[a].invert ? "on" : "off");
  } else if (c == "speed" && n >= 2) {
    settings.motion.maxSpeedDegPerS = constrain(tok[1].toFloat(), 10.f, 600.f);
    applyCal();
  } else if (c == "idle" && n >= 2) {
    settings.motion.idleDetachMs = (uint32_t)max(0L, tok[1].toInt());
    applyCal();
  } else if (c == "save") {
    saveSettings(settings);
    Serial.println("saved");
  } else if (c == "status") {
    JsonDocument j;
    statusJson(j.to<JsonObject>());
    serializeJson(j, Serial);
    Serial.println();
  } else if (c == "wifi" && n >= 2) {
    int p = cmd.indexOf(tok[1]) + tok[1].length();
    String pass = cmd.substring(p);
    pass.trim();
    joinWifi(tok[1], pass);
  } else if (c == "setup") {
    enterSetupMode(n >= 2 ? (uint32_t)tok[1].toInt() * 1000 : 0);
  } else if (c == "token" && n >= 2 && tok[1] == "new") {
    settings.token = newToken();
    saveToken(settings.token);
    Serial.printf("new token: %s\n", settings.token.c_str());
  } else if (c == "token") {
    Serial.printf("token: %s\n", settings.token.c_str());
  } else if (c == "detect") {
    JsonDocument in, out;
    std::string err;
    if (n >= 2) {
      if (tok[1] == "off") in["enabled"] = false;
      else { in["enabled"] = true; in["model"] = tok[1].c_str(); }
      if (!applyDetectJson(in.as<JsonObjectConst>(), err)) Serial.printf("? %s\n", err.c_str());
    }
    detectionsJson(out.to<JsonObject>());
    serializeJson(out, Serial);
    Serial.println();
  } else if (c == "follow" && n >= 4 && tok[1] == "signs") {
    JsonDocument in;
    std::string err;
    in["panSign"] = tok[2].toInt();
    in["tiltSign"] = tok[3].toInt();
    applyFollowJson(in.as<JsonObjectConst>(), err);
    Serial.printf("follow signs pan %d tilt %d\n", settings.followPanSign, settings.followTiltSign);
  } else if (c == "follow") {
    JsonDocument in;
    std::string err;
    if (n >= 2) in["enabled"] = tok[1] == "on";
    applyFollowJson(in.as<JsonObjectConst>(), err);
    Serial.printf("follow %s (detect %s, %s)\n", settings.follow ? "on" : "off", detectEnabled() ? "on" : "off",
                  detectModelName(detectModel()));
  } else if (c == "preset") {
    JsonDocument in, out;
    std::string err;
    if (n >= 3) {
      in["action"] = tok[1] == "del" ? "delete" : tok[1].c_str();
      in["name"] = tok[2].c_str();
      if (!presetAction(in.as<JsonObjectConst>(), err)) Serial.printf("? %s\n", err.c_str());
    }
    presetsJson(out.to<JsonObject>());
    serializeJson(out, Serial);
    Serial.println();
  } else if (c == "patrol" && n >= 2) {
    JsonDocument in;
    std::string err;
    in["enabled"] = tok[1] == "on";
    if (n >= 3) {
      JsonArray a = in["presets"].to<JsonArray>();
      int from = 0;
      while (from <= (int)tok[2].length()) {
        int comma = tok[2].indexOf(',', from);
        if (comma < 0) comma = tok[2].length();
        if (comma > from) a.add(tok[2].substring(from, comma));
        from = comma + 1;
      }
    }
    if (n >= 4) in["dwellS"] = tok[3].toInt();
    if (!applyPatrolJson(in.as<JsonObjectConst>(), err)) Serial.printf("? %s\n", err.c_str());
    else Serial.printf("patrol %s\n", patrol.on() ? "on" : "off");
  } else if (c == "info") {
    Serial.printf("lynx %s  %s  http://%s/  ip %s  wifi %s%s\n", kVersion, hostName().c_str(), mdnsName().c_str(),
                  staIp().length() ? staIp().c_str() : "-", wifiState(), setupMode() ? "  (setup hotspot up)" : "");
    if (!cameraReady()) Serial.printf("camera: %s\n", cameraError.c_str());
  } else {
    Serial.printf("? unknown or incomplete: '%s' (try help)\n", cmd.c_str());
  }
}

static void pollSerial() {
  while (Serial.available()) {
    char ch = (char)Serial.read();
    if (ch == '\n' || ch == '\r') {
      if (line.length()) handleCommand(line);
      line = "";
    } else if (line.length() < 160) {
      line += ch;
    }
  }
}

// ---------- entry points ----------

void setup() {
  Serial.begin(115200);
  lockBegin();
  // servos own LEDC timers 0-1; the camera clock is on timer 3 (camera.cpp)
  ESP32PWM::allocateTimer(0);
  ESP32PWM::allocateTimer(1);
  loadSettings(settings);
  motion.begin(settings.cal[PAN], settings.cal[TILT], settings.motion, millis());
  motion.center(millis());  // boot into the rest pose

  if (!cameraBegin(settings.camera, cameraError)) Serial.printf("camera: %s\n", cameraError.c_str());
  follower.config().panSign = settings.followPanSign;
  follower.config().tiltSign = settings.followTiltSign;
  follower.config().restTilt = Motion::kRestTiltDeg;
  loadPresets(presets);
  loadPatrol(patrolSaved);
  restartPatrol(millis());
  detectBegin();
  sdBegin();
  detectSet(settings.detect, settings.detectModel, settings.detectRange);
  netBegin();
  webBegin();
  streamBegin();
  otaBegin();
#ifdef LYNX_CRASH_TEST  // a deliberately broken build, to prove OTA rollback: crashes before it can confirm itself
  delay(5000);
  Serial.println("LYNX_CRASH_TEST: crashing on purpose");
  abort();
#endif
  Serial.printf("lynx %s ready as %s (type 'help')\n", kVersion, hostName().c_str());
}

void loop() {
  uint32_t now = millis();
  pollSerial();
  netLoop();
  pollFollow(now);
  pollPatrol(now);
  otaLoop();
  {
    MotionLock l;
    motion.update(now);
    driveServos();
  }
  delay(2);
}
