alexnodeland/lynx/(commit log)

2026-10-20 feat: lynx pan/tilt camera — CAD, production files, firmware, electronics, landing page
    Claude-Session: https://claude.ai/code/session_01MBBuMNMMsvkZ54jHaR2o2x
    [lynx-assembly.step, lynx-base.step, lynx-base.stl, lynx-batterytray.step, lynx-batterytray.stl, lynx-lid.step, lynx-lid.stl, lynx-lightpipe.step]
2026-10-20 perf(web): scroll-locked smooth motion
    Scroll sets a goal that the scene follows with a critically damped spring,
    so wheel steps glide instead of jumping. Cable tubes are rewritten in place
    rather than reallocated every frame, shaders compile before reveal, beat
    offsets are cached, the rail fill is a transform, and AO runs at half res.
    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
2026-10-21 feat: rest pose leans the lens 45 degrees toward the front
    Tilt 0 points the lens straight up. The site, the firmware's centre
    command and boot pose, and its web UI now rest at tilt 45. A CAD sweep
    confirms tilt -90..+90 is collision-free. The hero banner and social
    preview are re-rendered at the new pose.
    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
    [main.cpp]
2026-10-21 style(web): glass buttons, and only GitHub in the header
    The Motion and Build header links repeated the chapter rail. Every button
    now uses the slabs' glass: tinted blur, lit rim, cursor sheen.
    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
2026-10-21 feat(firmware): LAN control layer: REST API, MCP server, camera stream, setup hotspot
    The firmware becomes the product image: pan/tilt motion plus the camera,
    reachable over the local network.
    - REST API on port 80: position, rest pose, sweep, camera settings, snapshots
    - MCP server at /mcp (Streamable HTTP, stateless, tools only), serving both
    2026-07-28 (server/discover, _meta versioning, header checks) and the
    2025-11-25/06-18/03-26 initialize handshake
    - MJPEG stream on its own server (port 81) so a viewer never blocks control
    - per-device 128-bit token on every endpoint; Origin guard on /mcp
    - first-boot hotspot lynx-xxxx with captive setup page, mDNS lynx-xxxx.local,
    BOOT held 3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
2026-10-21 fix(firmware): bring-up findings: hotspot close rules, mDNS over IPv6, quiet first boot
    First run on a XIAO ESP32-S3 Sense: boot, camera, PSRAM, captive setup on a
    phone, join, REST, MCP and the stream all work. Three fixes from it:
    - the setup hotspot could stay open after joining; its rules now live in
    lib/netplan with explicit timestamps and 9 native tests over real sequences
    - lynx-xxxx.local took 5 s to resolve on macOS/iOS (AAAA first); the station
    now has an IPv6 link-local address and lookups take ~5 ms
    - a fresh board no longer logs NOT_FOUND for every default setting
    - /api/info, status and the mDNS TXT record carry the full-MAC device id
    - serial `setup [s]` opens the hotspot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
    [main.cpp, net.cpp, net.h, settings.cpp, web.cpp]
2026-10-21 feat(hass): Home Assistant integration, installable from HACS
    custom_components/lynx: zeroconf discovery on _lynx._tcp (unique id = MAC from
    TXT), config flow with token, reauth, reconfigure, and DHCP-follow. Entities:
    camera (snapshot stills + proxied MJPEG; no stream_source, given the single
    viewer slot), pan/tilt sliders bounded by the device's soft limits, rest-pose
    and sweep buttons, resolution select, flip/mirror switches, brightness and
    JPEG quality, moving binary sensor, Wi-Fi/boot/memory diagnostics, and a
    lynx.look entity action. Diagnostics redact the token.
    20 tests (pytest-homeassistant-custom-component, HA 2026.10); CI runs them
    with ruff, hassfest and the HACS validator.
    Cla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
2026-10-21 feat(web): 3D build guide, from printed parts to a camera on your network
    build.html walks the whole process in 13 steps (prepare, build, wire, use) on
    the landing page's own scene: parts from earlier steps sit assembled, the
    step's parts fly in, the rest is a ghost of the finished camera, the cable
    draws itself along its CAD route, and the parts a step is about pulse. Orbit
    with the mouse; step with the rail, the arrow keys or #step links. Content
    follows the BOM.
    The shared scene moved out of main.js into stage.js (renderer, set, rig,
    cables, post), so both pages render the same model; the landing page is
    pixel-identical after the move. 'Build guide' joins the header.
    Claude-Session: htt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
2026-10-21 docs: a docs hub, architecture, troubleshooting, contributing; just + pre-commit DX
    - justfile: setup, check (the whole CI gate locally), firmware/device/HA/web
    recipes, release
    - pre-commit: whitespace/YAML/JSON/TOML, ruff, firmware native tests, HA
    strings/translations kept identical; a lint workflow runs the same hooks
    - docs/: a hub by goal (build / use / change), architecture with diagrams, and
    troubleshooting from real bring-up
    - CONTRIBUTING, CHANGELOG, issue templates (bug, build report), PR template,
    editorconfig, gitattributes, VS Code recommendations
    - README links the 3D build guide, the flasher and the docs up top
    Verified from scratch: just setup && just check passes.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
2026-10-21 feat(firmware): on-device face detection and follow mode
    ESP-DL (bundled with arduino-esp32 for the S3) detects human faces (MSR01 +
    MNP01) or cat faces (MN03) in its own task, on a scaled copy of each JPEG:
    ~3.6 fps at range far, ~4.1 at near; the stream holds 20 fps either way.
    Follow mode keeps the nearest face centred with no-overshoot track moves
    (new MoveStyle::Track), holds, then returns to rest; manual moves pause it.
    - lib/follow with 9 native tests incl. a closed loop (49 total)
    - REST /api/detections, /api/detect, /api/follow, /api/detect/image
    (?debug=1 returns the model's input); MCP detect + follow tools
    - Home Assistant: detected (occupancy), count, detection + follow switc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
    [app.h, camera.cpp, detect.cpp, detect.h, main.cpp, pages.h]
2026-10-21 feat(firmware): custom detection models from Edge Impulse
    - just capture <label>: lynx pans over the room and saves training shots
    - just model-add export.zip: installs an Edge Impulse Arduino export as
    model: custom (FOMO boxes, or a classifier's winning label), via a shim
    header and __has_include, so the firmware builds the same without one;
    ESP-NN switched to its optimised-C kernels (exports lack the S3 asm)
    - per-box labels; custom in the API, MCP (detect model enum) and Home
    Assistant (offered only when the device reports a model)
    - CI builds the firmware with Seeed's public Edge Impulse export for the
    XIAO ESP32-S3, so the adapter can't rot
    - docs/custom-models.md: capture ->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
2026-10-21 feat: presets and patrol, with one arbiter for the head
    Up to 8 named positions and a patrol tour with a dwell at each, saved
    in NVS and resumed after a reboot. lib/presets also holds the arbiter
    that settles who moves the head: a person's command (5 s) > follow while
    it sees a face > patrol, so a patrol stops for someone who walks in.
    REST /api/presets, /api/patrol; MCP preset + patrol tools; serial
    preset/patrol; Home Assistant preset select, patrol switch, save/delete
    preset actions. 58 native tests, 25 HA tests; verified on the board
    (go, patrol order and dwell, manual hold, reboot persistence).
    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
    [app.h, main.cpp, settings.cpp]
2026-10-21 feat: several viewers at once, and pushed status events
    Port 81 is now a small server of its own instead of an esp_http_server
    instance (whose single task held one viewer): one producer task takes each
    camera frame once into a shared PSRAM buffer, and each client (up to 4)
    gets its own task with send/receive timeouts, so a slow viewer only slows
    itself. GET :81/events streams the status as server-sent events on every
    change. Token auth via lib/auth; 401/404/405/503 as appropriate.
    On the board: three viewers at ~15 fps each, a fifth connection 503,
    events on a move and a setting change, 120 KB heap free with 4 open.
    Home Assistant follows /events for instant updates and keeps polling as
    th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
2026-10-21 feat: over-the-air updates with automatic rollback
    POST /api/update streams an app image into the spare OTA slot after
    checking the ESP32-S3 header, the app descriptor (so the merged web-flasher
    image can't be flashed by mistake) and an optional X-Lynx-SHA256, then
    reboots. A new image runs pending verification and confirms itself after
    45 s of healthy running (verifyRollbackLater); anything that crashes,
    hangs or reboots sooner is rolled back by the bootloader.
    On the board: wrong image 415, wrong hash 422 (nothing flashed), no token
    401, a real update switched slots and confirmed, and a build that crashes
    on purpose (-DLYNX_CRASH_TEST) rolled back to the good image with no USB.
    - dashboa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
    [detect.cpp, main.cpp, ota.cpp, ota.h, pages.h, stream.cpp]
2026-10-21 feat: record to microSD on detection and as a timelapse
    lib/recorder decides: a burst of three when something appears, then one
    every 30 s while it stays; a timelapse every N minutes; past 90 % full,
    delete the oldest until under 80 %; and which paths the API may touch.
    src/sdcard (SPI, CS 21) carries it out in its own task, naming files
    /lynx/YYYYMMDD/HHMMSS_kind.jpg from NTP time (UTC).
    REST /api/sd (+ list, file, delete), MCP recordings tool (get returns an
    image), Home Assistant switch / interval / usage sensor that are
    available only with a card. Off by default. 67 native, 34 HA tests.
    On the board (via OTA): no card in the slot, so mounting reports none and
    the API refuses cleanly; N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
2026-10-21 feat(mcp): annotated snapshots with the current detections drawn on
    snapshot {annotate: true} decodes the frame (<= 800 px wide), draws the
    fresh detection boxes in green in the camera's byte order, and re-encodes
    it: an agent sees what lynx sees. 0.65 s at 640x480 on the board; the
    colours round-trip correctly (box drawing awaits a face in view).
    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
    [detect.cpp, detect.h, web.cpp]
2026-10-21 feat(hardware): carrier PCB generated in KiCad, routed and checked
    make_carrier.py writes the KiCad 10 schematic and 18 x 14 mm two-layer board,
    autoroutes it with Freerouting, stitches the ground pours, and fails unless
    ERC and DRC (with schematic parity) are clean. Gerbers, drill, JLCPCB BOM/CPL,
    PDFs, STEP and renders land in fab/. 'just pcb' runs it.
    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
    [lynx-carrier-B_Cu.gbl, lynx-carrier-B_Mask.gbs, lynx-carrier-B_Paste.gbp, lynx-carrier-B_Silkscreen.gbo, lynx-carrier-Edge_Cuts.gm1, lynx-carrier-F_Cu.gtl, lynx-carrier-F_Mask.gts, lynx-carrier-F_Paste.gtp]
2026-10-21 fix(web): smooth scrolling on phones
    Drop scroll-snap, stop resizing the GL buffers and rebuilding the timeline
    when the address bar moves, read scroll once per frame, and on touch skip
    backdrop blur, AO and depth of field and cap pixel ratio at 1.25.
    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
2026-10-21 docs: lead the README and site with agents, Home Assistant, tracking and custom models
    The site's chapters become agents, home, track, train and build: a scripted
    MCP exchange turns the head, presets and patrol play out against mock
    Home Assistant entities, follow mode chases a face, lynx scans the room for
    training shots, and the hardware story folds into one build chapter. The
    CTA adds Home Assistant and agent buttons. The README opens with the four
    features and their snippets; hardware moves below.
    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
2026-10-21 feat: MCP guide for agents, token throttle and rotation, HA brand images, parts cost
    - MCP: fuller instructions, a guide tool and lynx://guide resource, lynx://status,
    prompts look_around/find/check, argument descriptions and tool hints on every tool.
    - Security: per-address throttle on wrong tokens (429 + Retry-After) on ports 80 and
    81, POST /api/token/rotate, an HA Rotate token button that stores the new token,
    docs/security.md threat model and SECURITY.md.
    - HACS: brand images in custom_components/lynx/brand; the brands check now runs.
    - BOM: a cost section (about $43 per camera, $55 with options, ~$80 first build).
    Claude-Session: https://claude.ai/code/session_01MBBuMNMMsvkZ54jH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
    [pages.h, stream.cpp, web.cpp, web.h]
2026-10-21 docs(firmware): microSD recording verified on the board; the card is read at boot
    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
