alexnodeland/lynx/(notices)

Notices in the files:
hardware/electronics/README.md:
Licence: CERN-OHL-S-2.0
web/README.md:
Licence: MIT
README.md:
Hardware licence
